StSandwich/ROV/Structure/Images/7b80ec35-c6fb-4c0f-8c48-df3105a3505e.png

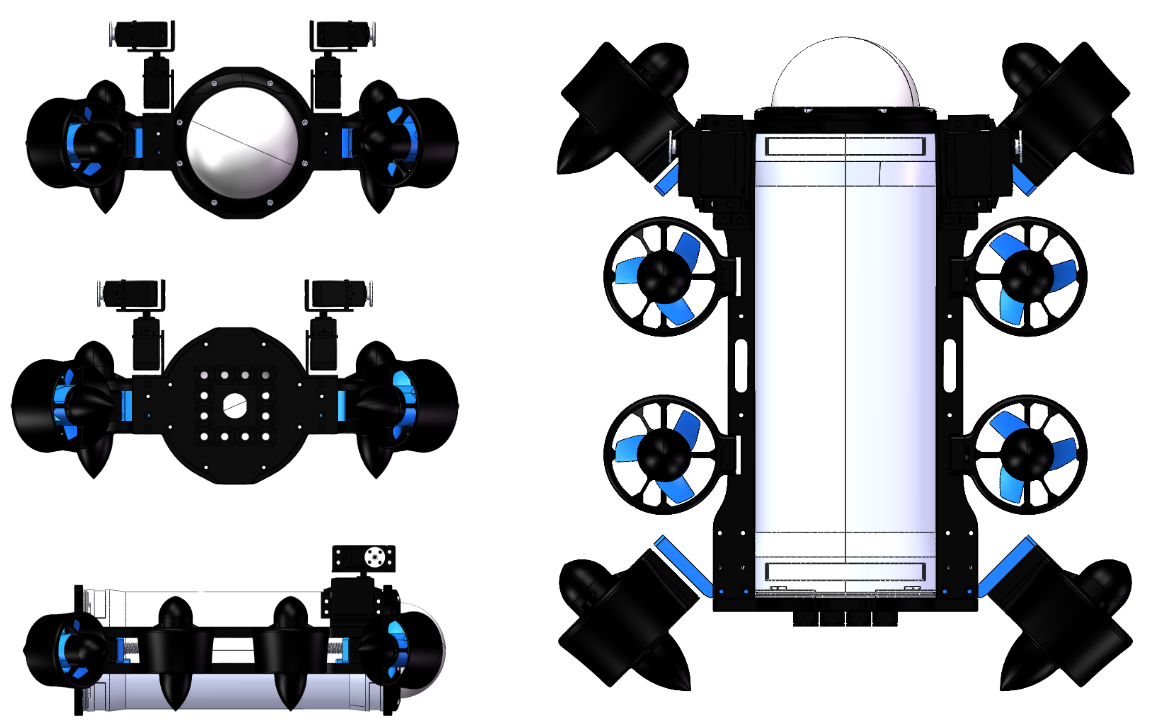
Structure/Images/7b80ec35-c6fb-4c0f-8c48-df3105a3505e.png
