StSandwich/ROV/Structure/En/BOM.xlsx

Type | Item Description | Link | Detail | Price(CNY) | Number | Note
Disclaimer | We are not affiliated with or endorse this company in any way. We have not tested or validated the product. Any such offerings are independent of our project.
 | If you are from regions outside mainland China or areas where Taobao e-commerce services are not readily available, you may refer to the BOM specifications to purchase equivalent items through convenient channels, but we cannot guarantee the consistency of the final assembly results. |  |  |  |  |  | The quantity of screws is for reference only; please prepare extra ones.
Essentials
Structure | Rear cabin hatch |  | Custom Aluminum Alloy CNC Machining | 240 | 1 |  | Category | Type | Number
 | Front cabin mount |  |  | 180 | 1 |  | Countersunk Head Hexagon Socket Screw | M3(Head Diameter6)*5 | 20
 | Thruster mount |  |  | 680 | 4 |  |  | M3(Head Diameter6)*10 | 8
 | Horizontal thruster bracket |  |  | 480 | 4 |  |  | M3(Head Diameter8)*8 | 16
 | Cable-passing screw |  |  | 1140 | 12 |  | Cup Head Hexagon Socket Screw | M4*16 | 32
 | Underwater aviation connector | https://item.taobao.com/item.htm?spm=a1z09.2.0.0.18002e8dzucueB&id=619481441943&_u=f2ig9se45843 | 3W 6-Core | 272 | 1 | Send cable directly to supplier for processing. |  | M3*16 | 20
 | Servo connector | https://item.taobao.com/item.htm?id=557166026079&sku_properties=31309:48651884 | Multifunctional Bracket | 18.4 | 4 |  |  | M3*12 | 45
 |  |  | Metal Servo Horn | 10 | 4 |  |  | M3*10 | 8
 | Waterproof compartment | https://item.taobao.com/item.htm?spm=a1z09.2.0.0.ef7d2e8dO2XjuV&id=662343463249&_u=92ig9se46f55 | Cabin Tube & Flange Kit + Hemispherical Cover + Pressure Plate | 515 | 1 |  |  | M2.5*8 | 4
 | Internal bracket of waterproof compartment | 3D打印 |  |  |  |  |  | M2*10 | 48
Electronics | Propeller | https://item.taobao.com/item.htm?spm=a1z09.2.0.0.ef7d2e8dO2XjuV&id=591864716045&_u=92ig9se435ad | 1 Pair of CW/CCW Propellers (Built-in ESC for 4S Voltage) | 2037 | 4 |  |  | M3*4 | 12
 | Servo | LIEYING/QFS2025全防水/潜水/水下机器人舵机全金属外壳IPX68等级-淘宝网 (taobao.com) (https://item.taobao.com/item.htm?_u=i20at7545jacc4&id=680656749408&spm=a1z09.2.0.0.3c6c2e8dmFwRSe) | 20KG (for Underwater Diving) Underwater Robot, 180° (0.5-2.5ms) | 432 | 4 | Custom extended cable, total length 1m. |  | M2.5*4 | 4
 | Water depth sensor | M10 水压水深传感器 高精度 深度传感器 MS5837-30BA 带温度 ROV-淘宝网 (taobao.com) (https://item.taobao.com/item.htm?_u=320at7545j5b4a&id=605375059849&spm=a1z09.2.0.0.2d472e8d3f5Wg1) | Standard Version, Stainless Steel, 10m, Sensor Adapter Board Kit | 1319.6 | 4 | Custom extended cable, total length 60cm. | Single-head Copper Spacer | M3*4+4 | 12
 | I2C expansion board | TCA9548A IIC多路扩展模块 8路I2C通信 I2C开关开发-淘宝网 (https://item.taobao.com/item.htm?id=677595693967&skuId=6126765579570) | Straight/Right-Angle Pin Headers | 10.56 | 1 |  |  | M2.5*4+4 | 4
 | PWM expansion board | 16路PWM Servo 舵机驱动板机器人控制器IIC接口驱动器模块PCA9685-tmall.com天猫 (https://detail.tmall.com/item.htm?_u=m20at7545j0770&id=624960039615&spm=a1z09.2.0.0.570d2e8dWadFaY) | Pre-Soldered | 15 | 1 |  | Hexagonal Single-head Nylon Spacer | M3*70+6 | 6
 | TTL to 422 converter | RS422互转TTL双向信号 全双工422转单片机MAX490转TTL模块-tmall.com天猫 (https://detail.tmall.com/item.htm?_u=q2ig9se4d19b&id=715839278393) |  | 9.1 | 1 |  |  | M3*45+6 | 3
 | 422 to USB converter | 绿联usb转rs485/422/232串口线工业级九针db9针数据调试接口通讯模块芯片连接笔记本和电脑口转接头转换器-tmall.com天猫 (https://detail.tmall.com/item.htm?id=599997955029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) | 1 Piece, Length Customizable | 79 | 1 |  |  | M3*40+6 | 3
 | Wireless debugger | 高速无线调试器DAPLink仿真器STM32编程烧录下载器塔克OpenCTR-淘宝网 (https://item.taobao.com/item.htm?abbucket=8&id=745548099223&ns=1&skuId=5310177214467&xxc=taobaoSearch) | 2 Debuggers + Dupont Cables | 89 | 2 |  | Cap Nut | M3 | 16
 | DJI RoboMaster C-board | ROBOMASTER萝马集市 开发板C型-淘宝网 (taobao.com) (https://item.taobao.com/item.htm?_u=i20at7545j5174&id=611226266955&spm=a1z09.2.0.0.292e2e8d43HZbM) |  | 379 | 1 |  | Hex Nut | M3 | 4
 | Camera |  | Either External Waterproof Camera or Internal Cabin Camera is Acceptable |  | 1 |  | Embedded Nut | M3*4+6 | 4
Others | Cable |  | Custom Zero-Buoyancy Cable: 2p*1mm² Power Cable + 4p Signal Cable
 | Screw |  | See the right table
 | Terminal block | https://item.taobao.com/item.htm?id=562191894078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 | h3802 10P | 25.2 | 2
 |  |  | Chocolate Color [EBL-10-5-Connector], Non-printed | 12.6 | 2
 |  | https://item.taobao.com/item.htm?spm=a1z09.2.0.0.5b912e8dQl5wtC&id=661948958655&_u=h2ig9se4f606 | h3800 12P | 36 | 2
 |  |  | h3800 16P | 24 | 1
 | Terminal block
 | Dupont adapter cable |  | 4P 100mm to Dupont Female SH1.25; 3P 100mm to Dupont Female GH1.25
 | Dupont cable |  | 6-Color Male to Female, 10cm
 | Waterproof gasket | 绿色氟胶O型圈外10.5/11/11.5/12/12.5/13/13.5/14/14.5/15*1.5mm-tmall.com天猫 (https://detail.tmall.com/item.htm?id=680012535670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) | Outer Diameter 12mm*1.5mm |  | 12
