StSandwich/ROV/Structure/En/CNC_Machining/CNC_Maching.xlsx

Name | Quantity | Material | Remarks
Front_Cabin_Mount | 1 | Al Alloy Anodized Black
Rear_Cabin_Hatch | 1 | Al Alloy Anodized Black | All similar locations here: drill & tap M2 threaded holes, depth 4 mm, Qty. 48
Thruster_Mount | 4 | Al Alloy Anodized Black | All similar locations here: drill & tap M3 threaded holes, depth 10 mm, Qty. 12
Horizontal_Thruster_Bracket | 4 | Al Alloy Anodized Blue | All similar locations here: drill & tap M3 threaded holes, depth 8 mm, Qty. 6
Cable-passing_Screw | 12 | Al Alloy Anodized Black
