StSandwich/ROV/Structure/zh-CN/bom表.xlsx

类别 | 材料名称 | 购买链接 | 型号 | 价格 | 数量 | 备注
声明 | 本表格不涉及任何广告，物料均为机器人标准件，我方与店家无任何关联，亦未对其进行背书。我方尚未对该产品开展测试或验证工作，相关产品服务均独立于本项目存在
 |  |  |  |  |  |  | 螺丝数量仅供参考，请多预备
核心配件清单
机械零件 | 后密封舱盖支撑 |  | 铝合金CNC定制 | 240 | 1 |  | 螺丝种类 | 型号 | 数量
 | 前密封舱支撑 |  |  | 180 | 1 |  | 扁头内六角螺丝 | M3(头径6)*5 | 20
 | 推进器支撑 |  |  | 680 | 4 |  |  | M3(头径6)*10 | 8
 | 水平推进器架 |  |  | 480 | 4 |  |  | M3(头径8)*8 | 16
 | 穿线螺丝 |  |  | 1140 | 12 |  | 杯头内六角螺丝 | M4*16 | 32
 | 水下航插 | https://item.taobao.com/item.htm?spm=a1z09.2.0.0.18002e8dzucueB&id=619481441943&_u=f2ig9se45843 | 3W 6芯 | 272 | 1 | 可以将电缆直接寄给商家加工 |  | M3*16 | 20
 | 舵机连接件 | https://item.taobao.com/item.htm?id=557166026079&sku_properties=31309:48651884 | 多功能支架 | 18.4 | 4 |  |  | M3*12 | 45
 |  |  | 金属舵盘 | 10 | 4 |  |  | M3*10 | 8
 | 防水舱 | https://item.taobao.com/item.htm?spm=a1z09.2.0.0.ef7d2e8dO2XjuV&id=662343463249&_u=92ig9se46f55 | 舱管和法兰套装+ 半球罩+压板 | 515 | 1 |  |  | M2.5*8 | 4
 | 防水舱内部支架 | 3D打印 |  |  |  |  |  | M2*10 | 48
电气设备 | 推进器 | https://item.taobao.com/item.htm?spm=a1z09.2.0.0.ef7d2e8dO2XjuV&id=591864716045&_u=92ig9se435ad | 正反桨（4S电压内置电调）一对（开票价） | 2037 | 4 |  |  | M3*4 | 12
 | 舵机 | LIEYING/QFS2025全防水/潜水/水下机器人舵机全金属外壳IPX68等级-淘宝网 (taobao.com) (https://item.taobao.com/item.htm?_u=i20at7545jacc4&id=680656749408&spm=a1z09.2.0.0.3c6c2e8dmFwRSe) | 20KG（水下潜水用）水下机器人 180度（0.5-2.5ms） | 432 | 4 | 需要定制加长线，总长1m |  | M2.5*4 | 4
 | 水深传感器 | M10 水压水深传感器 高精度 深度传感器 MS5837-30BA 带温度 ROV-淘宝网 (taobao.com) (https://item.taobao.com/item.htm?_u=320at7545j5b4a&id=605375059849&spm=a1z09.2.0.0.2d472e8d3f5Wg1) | 标准版 不锈钢 10m 传感器转接板套装 | 1319.6 | 4 | 需要定制加长线，总长60cm | 单头铜柱 | M3*4+4 | 12
 | IIC扩展板 | TCA9548A IIC多路扩展模块 8路I2C通信 I2C开关开发-淘宝网 (https://item.taobao.com/item.htm?id=677595693967&skuId=6126765579570) | 直/弯排针 | 10.56 | 1 |  |  | M2.5*4+4 | 4
 | PWM扩展板 | 16路PWM Servo 舵机驱动板机器人控制器IIC接口驱动器模块PCA9685-tmall.com天猫 (https://detail.tmall.com/item.htm?_u=m20at7545j0770&id=624960039615&spm=a1z09.2.0.0.570d2e8dWadFaY) | 焊好 | 15 | 1 |  | 六角单头尼龙柱 | M3*70+6 | 6
 | TTL转422 | RS422互转TTL双向信号 全双工422转单片机MAX490转TTL模块-tmall.com天猫 (https://detail.tmall.com/item.htm?_u=q2ig9se4d19b&id=715839278393) |  | 9.1 | 1 |  |  | M3*45+6 | 3
 | 422转USB | 绿联usb转rs485/422/232串口线工业级九针db9针数据调试接口通讯模块芯片连接笔记本和电脑口转接头转换器-tmall.com天猫 (https://detail.tmall.com/item.htm?id=599997955029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) | 1条，长度自选 | 79 | 1 |  |  | M3*40+6 | 3
 | 无线调试器 | 高速无线调试器DAPLink仿真器STM32编程烧录下载器塔克OpenCTR-淘宝网 (https://item.taobao.com/item.htm?abbucket=8&id=745548099223&ns=1&skuId=5310177214467&xxc=taobaoSearch) | 两个调试器+杜邦线 | 89 | 2 |  | 盖形螺母 | M3 | 16
 | 大疆RM C板 | ROBOMASTER萝马集市 开发板C型-淘宝网 (taobao.com) (https://item.taobao.com/item.htm?_u=i20at7545j5174&id=611226266955&spm=a1z09.2.0.0.292e2e8d43HZbM) |  | 379 | 1 |  | 六角螺母 | M3 | 4
 | 相机 |  | 外置防水相机或者舱内相机都可以 |  | 1 |  | 预埋螺母 | M3*4+6 | 4
其他 | 电缆 |  | 定制零浮力电缆 2p*1mm^2电源线+4p信号线 |  |  | 按需求定制长度 |  | M3*4+4 | 14
 | 螺丝 |  | 见右侧 |  |  |  |  | M2.5*3.5+4 | 4
 | 接线端子 | https://item.taobao.com/item.htm?id=562191894078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 | h3802 10p | 25.2 | 2
 |  |  | 巧克力色[EBL-10-5-连接件]不印字 | 12.6 | 2
 |  | https://item.taobao.com/item.htm?spm=a1z09.2.0.0.5b912e8dQl5wtC&id=661948958655&_u=h2ig9se4f606 | h3800 12p | 36 | 2
 |  |  | h3800 16p | 24 | 1
 | 接线端子
 | 杜邦转接线 |  | 4p100mm转杜邦母sh1.25 3p100mm转杜邦母gh1.25
 | 杜邦线 |  | 六色公对母10cm
 | 防水垫圈 | 绿色氟胶O型圈外10.5/11/11.5/12/12.5/13/13.5/14/14.5/15*1.5mm-tmall.com天猫 (https://detail.tmall.com/item.htm?id=680012535670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) | 外径12mm*1.5mm |  | 12
