StSandwich/ROV/Structure/zh-CN/CNC加工/CNC加工.xlsx

名称 | 数量 | 材料 | 备注
前密封舱支撑 | 1 | 铝合金，氧化黑
后密封舱盖 | 1 | 铝合金，氧化黑 | 此处所有类似地方需要做成m2螺纹孔，深4mm，共48个
推进器支撑 | 4 | 铝合金，氧化黑 | 此处需要做成m3螺纹孔，共12个
水平推进器架 | 4 | 铝合金，氧化蓝 | 此处需要做成m3螺纹孔，共6个
穿线螺丝M8 | 12 | 铝合金，氧化黑
