StSandwich/ROV/Structure/Configuration.STEP

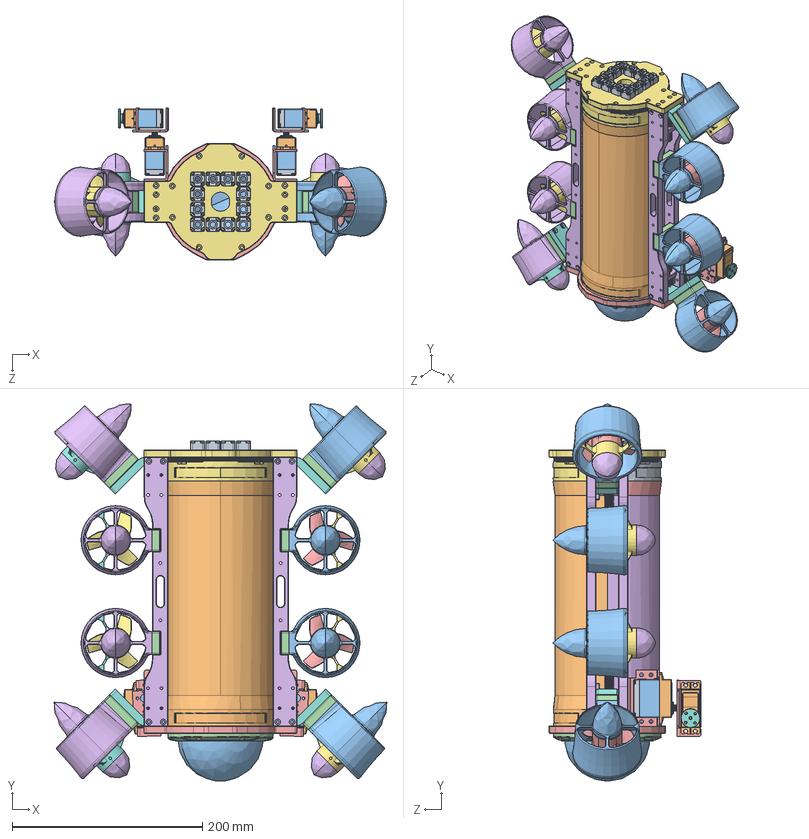
[picture p2: CAD file, 2026-01-31]
Structure/Configuration.STEP
349.5 x 396.2 x 159.6 mm
Cabin
YD11-24-2.stp x 4
PRT0001.stp x 4
9-16-2.stp x 4
YD11-24-1.stp x 4
YD11-24-3.stp x 4
Horizontal_Thruster_Bracket x 4
Servo x 3
Front_Cabin_Mount
MirrorYD11-24-2.stp x 4
MirrorPRT0001.stp x 4
Mirror9-16-2.stp x 4
MirrorYD11-24-1.stp x 4
MirrorYD11-24-3.stp x 4
Mirror_Servo
Hemispherical_Dome
Servo_mount x 4
Pressure_Sensor_Mount x 4
Pressure_Sensor x 4
Thruster_Mount x 4
Rear_Cabin_Hatch
Servo_Horn x 2
Cable-passing_Screw x 12
