StSandwich/ROV/Structure/En/3DPrinting/Pressure_Sensor_Mount.STEP

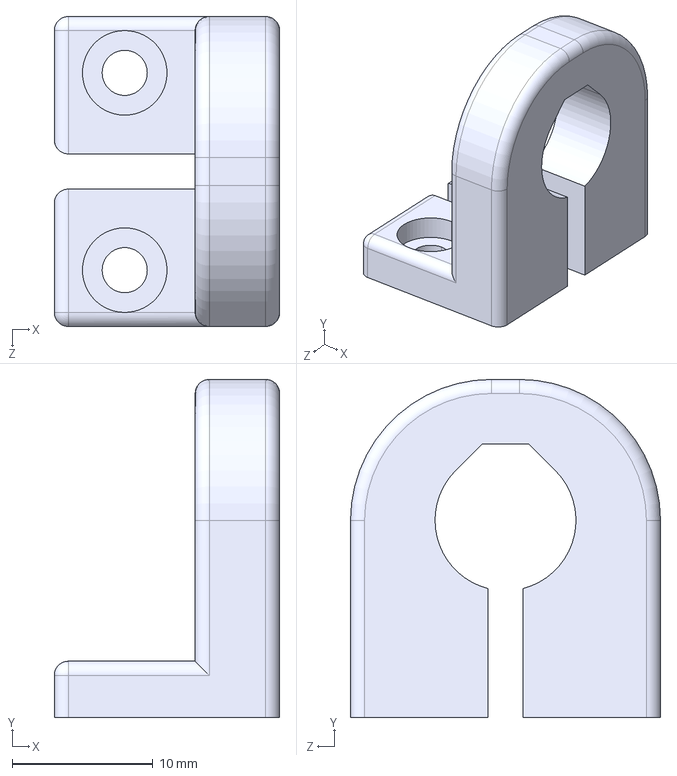
[picture p3: CAD file, 2026-01-31]
Structure/En/3DPrinting/Pressure_Sensor_Mount.STEP
16.0 x 24.0 x 22.0 mm
