StSandwich/ROV/Structure/En/Cabin/Cabin.STEP

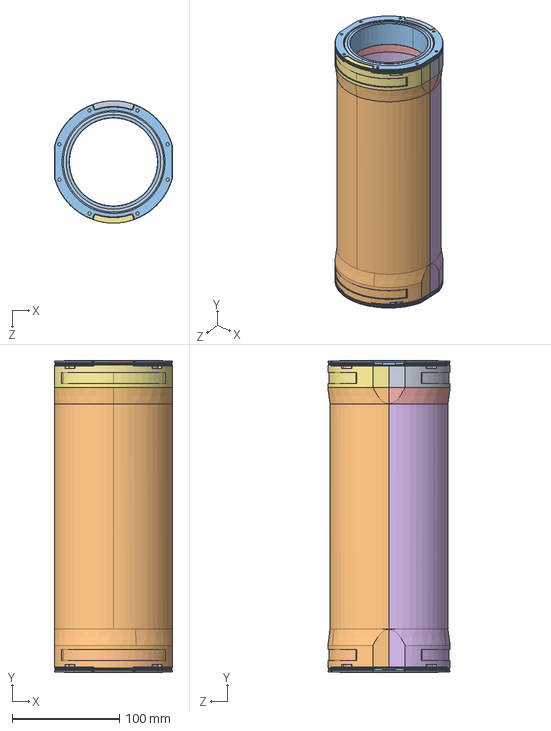
[picture p4: CAD file, 2026-01-31]
Structure/En/Cabin/Cabin.STEP
110.0 x 290.7 x 114.0 mm
