StSandwich/ROV/Structure/En/CNC_Machining/Rear_Cabin_Hatch.STEP

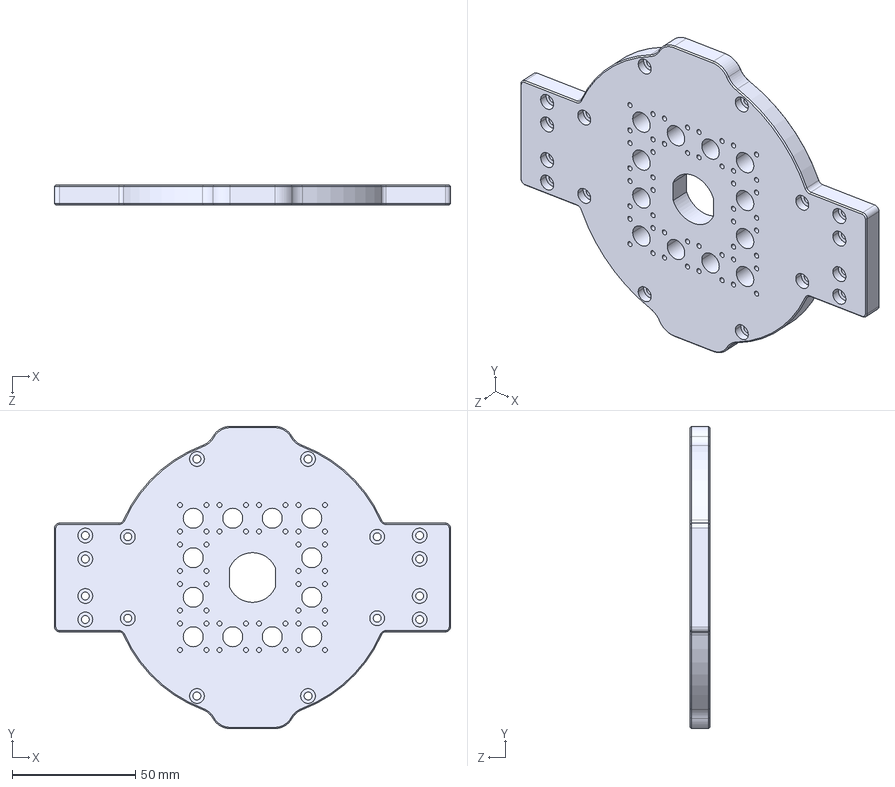
[picture p5: CAD file, 2026-01-31]
Structure/En/CNC_Machining/Rear_Cabin_Hatch.STEP
160.4 x 122.4 x 8.00 mm
