StSandwich/ROV/Structure/En/Configuration.STEP

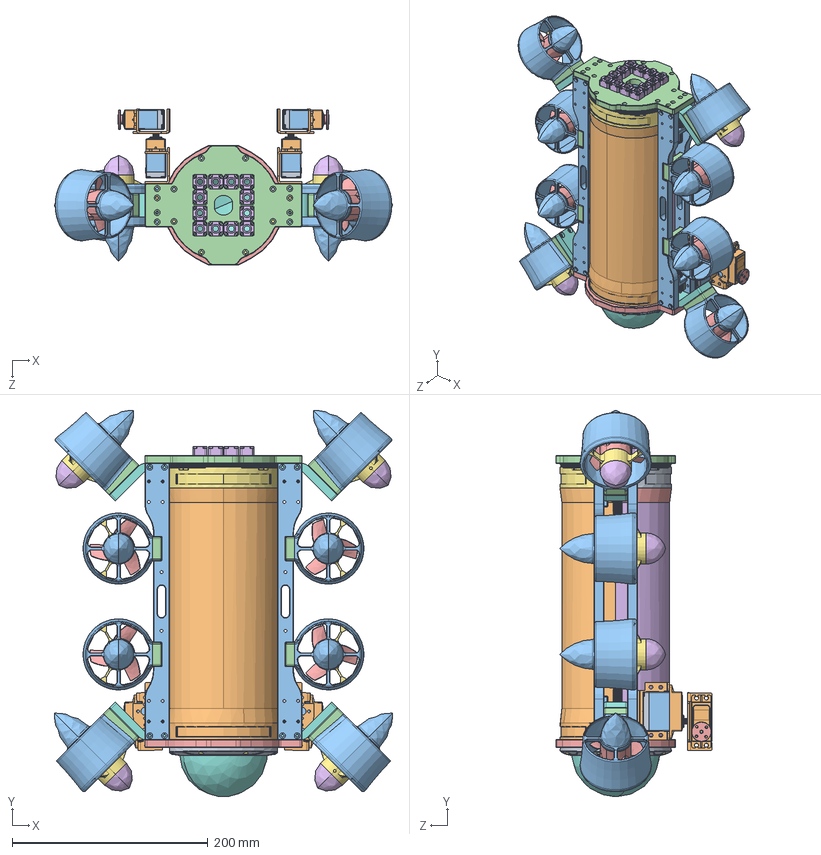
[picture p6: CAD file, 2026-01-31]
Structure/En/Configuration.STEP
345.0 x 393.9 x 159.6 mm
密封舱
YD11-24-2.stp x 8
PRT0001.stp x 8
9-16-2.stp x 8
YD11-24-1.stp x 8
YD11-24-3.stp x 8
水平推进器架 x 4
防水舵机 x 3
前密封舱支撑
镜向防水舵机
半球罩+压板
舵机多功能支架 x 4
水深传感器架 x 4
水深传感器 x 4
推进器支撑 x 4
后密封舱盖
舵盘 x 2
穿线螺丝M8 x 12
