StSandwich/ROV/Structure/En/Pressure_Sensor/Pressure_Sensor.STEP

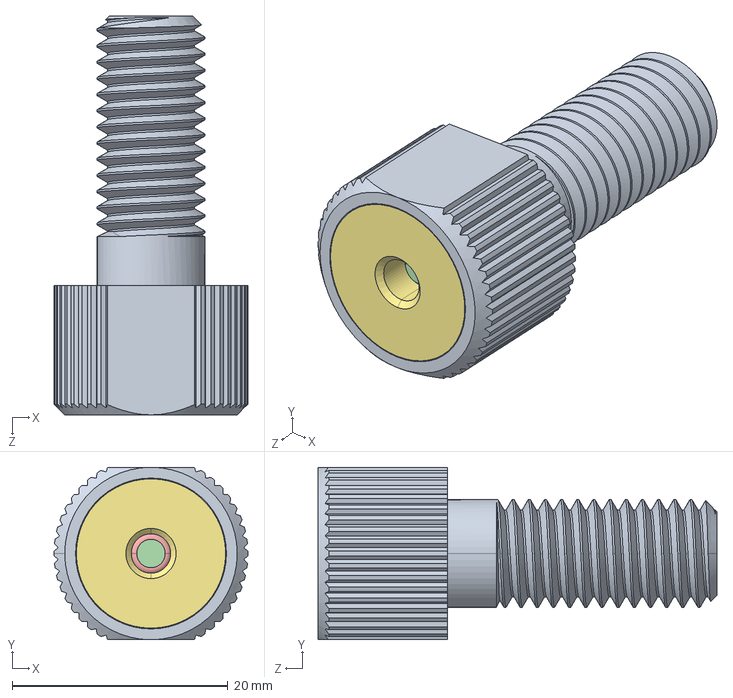
[picture p7: CAD file, 2026-01-31]
Structure/En/Pressure_Sensor/Pressure_Sensor.STEP
18.0 x 16.0 x 37.0 mm
