StSandwich/ROV/Structure/En/Servo/Servo_mount.STEP

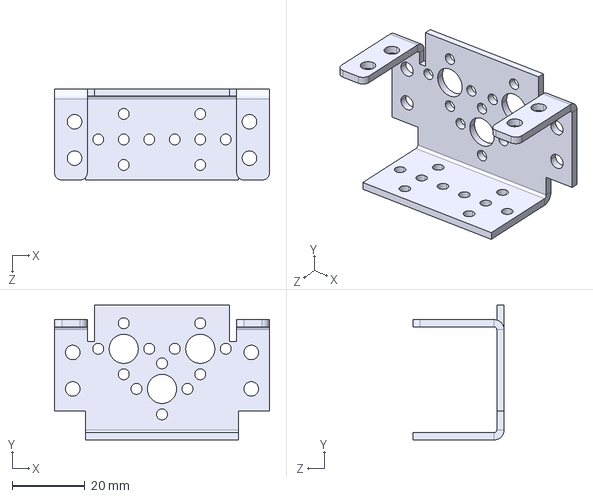
[picture p8: CAD file, 2026-01-31]
Structure/En/Servo/Servo_mount.STEP
59.0 x 37.0 x 25.0 mm
