StSandwich/ROV/Structure/En/Thruster/YD11-24-3.stp.STEP

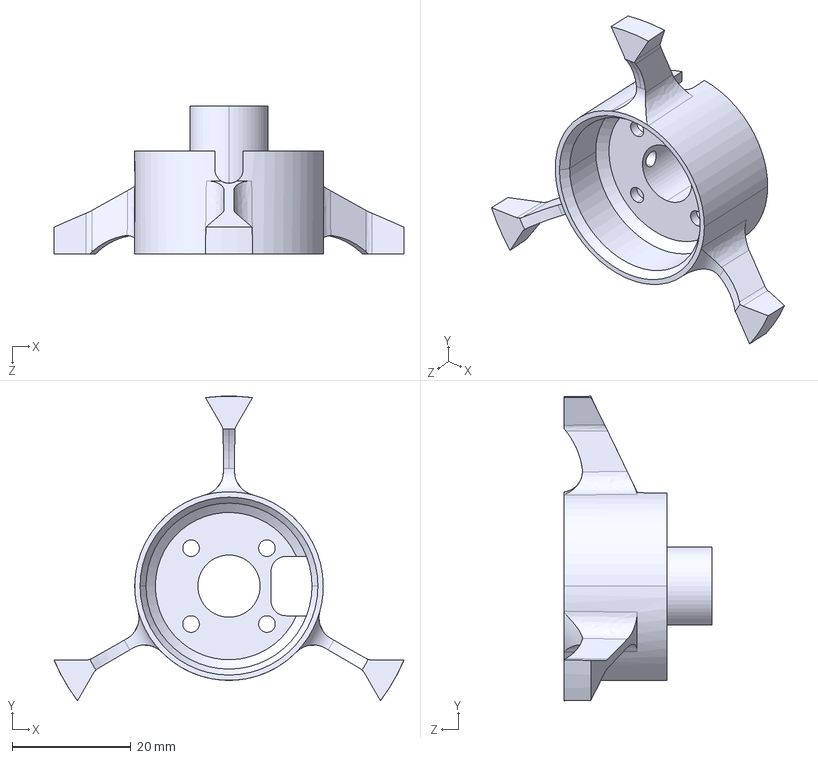
[picture p9: CAD file, 2026-01-31]
Structure/En/Thruster/YD11-24-3.stp.STEP
59.0 x 51.4 x 24.9 mm
