StSandwich/ROV/Structure/zh-CN/CNC加工/穿线螺丝M8.STEP

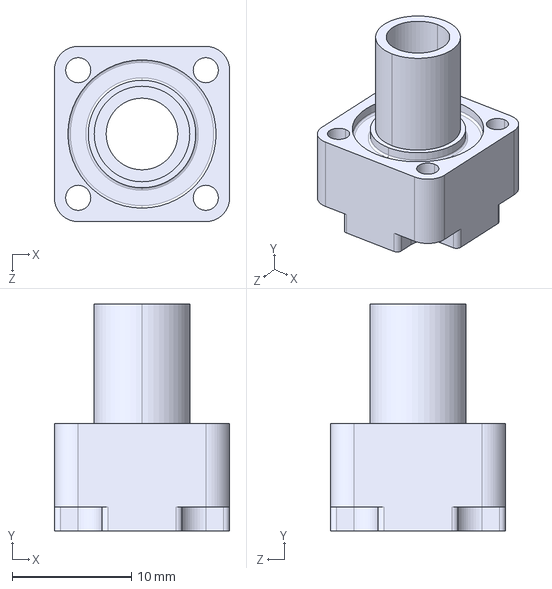
[picture p10: CAD file, 2026-01-31]
Structure/zh-CN/CNC加工/穿线螺丝M8.STEP
14.7 x 19.0 x 14.7 mm
