StSandwich/ROV/Structure/zh-CN/推进器/PRT0001.stp.STEP

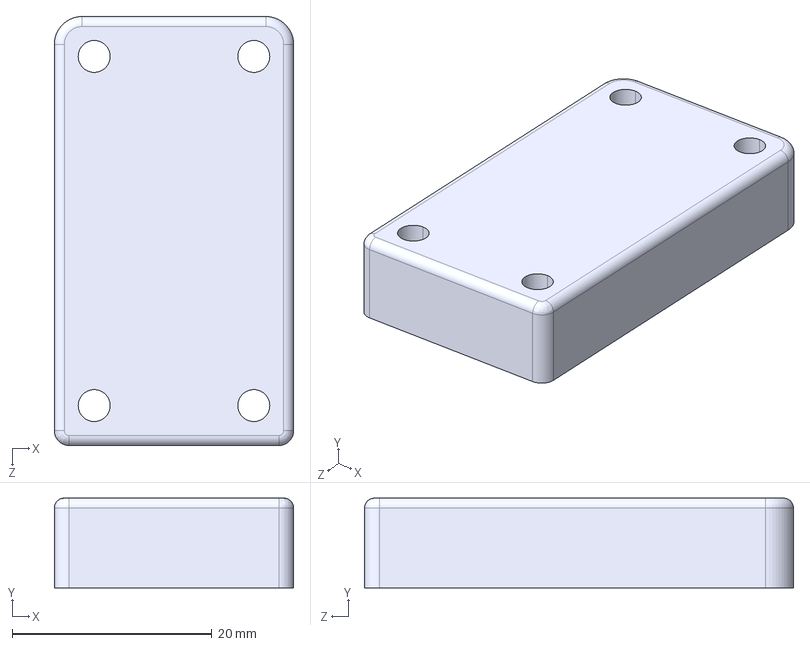
[picture p11: CAD file, 2026-01-31]
Structure/zh-CN/推进器/PRT0001.stp.STEP
24.0 x 9.00 x 43.0 mm
