StSandwich/ROV/Structure/En/Cabin/Hemispherical_Dome.STEP

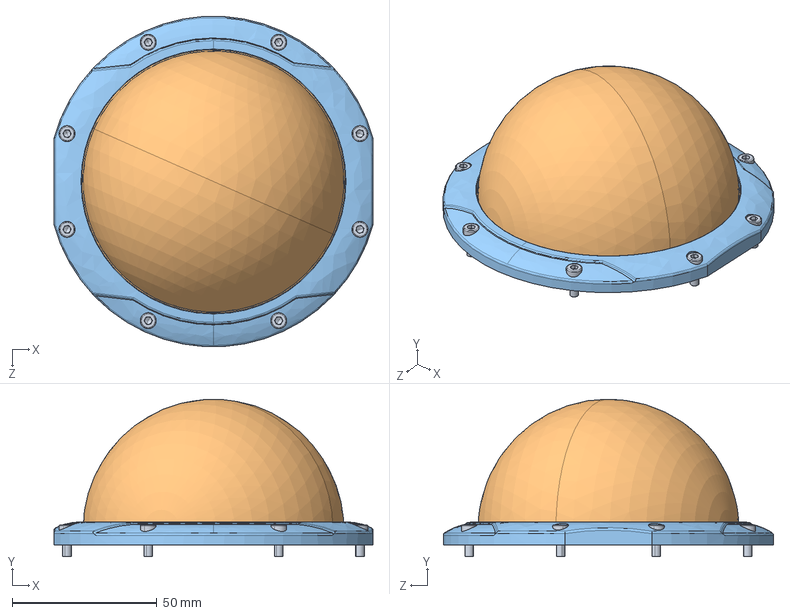
[picture p12: CAD file, 2026-01-31]
Structure/En/Cabin/Hemispherical_Dome.STEP
110.0 x 54.3 x 113.8 mm
