StSandwich/ROV/Structure/En/CNC_Machining/Front_Cabin_Mount.STEP

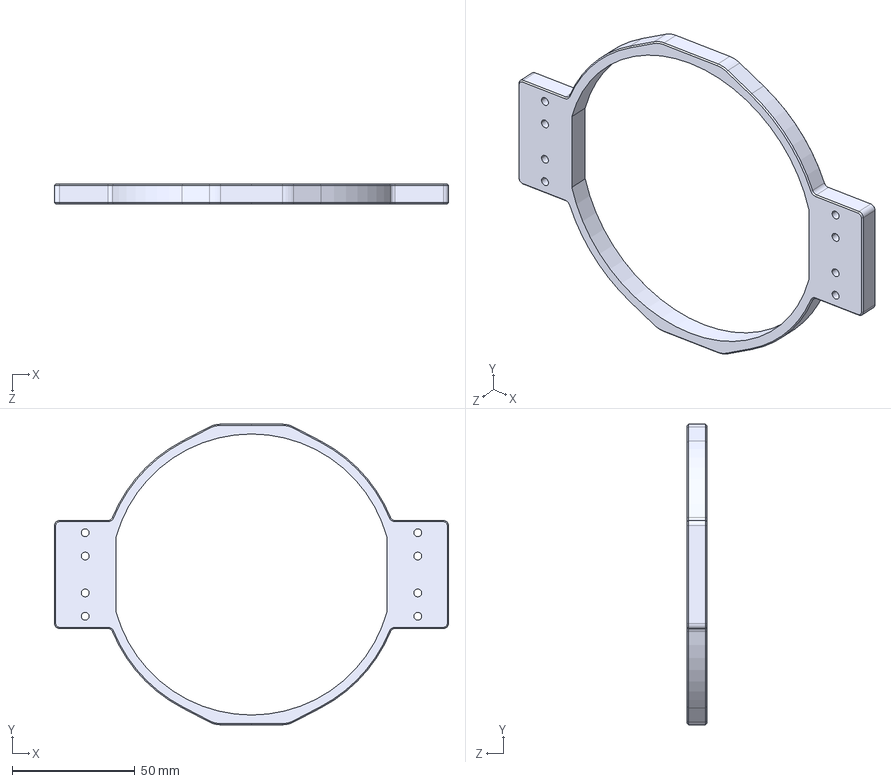
[picture p13: CAD file, 2026-01-31]
Structure/En/CNC_Machining/Front_Cabin_Mount.STEP
160.4 x 122.4 x 8.00 mm
