StSandwich/ROV/Structure/En/In-cabin_Layout.STEP

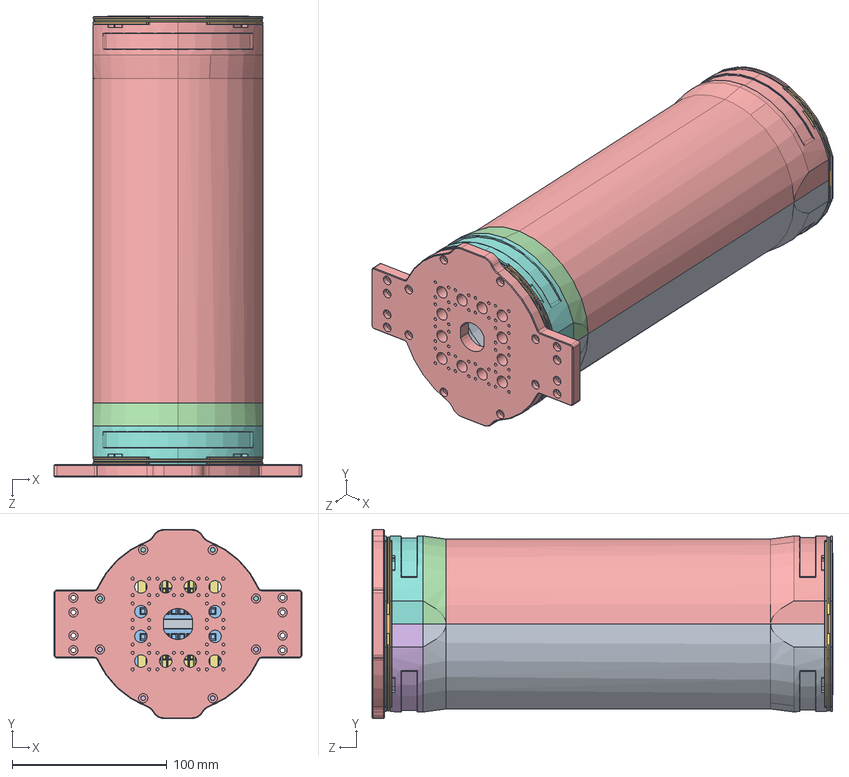
[picture p14: CAD file, 2026-01-31]
Structure/En/In-cabin_Layout.STEP
160.4 x 122.4 x 298.3 mm
接线端子支架
H3802-10P x 2
接线端子支架2 x 2
后密封舱盖
H3800-12P x 2
密封舱
电路板底板
H3800-16P
C板
I2C扩展板
PWM扩展板
stlink
电路板支架
