StSandwich/ROV/Structure/En/Servo/Servo.STEP

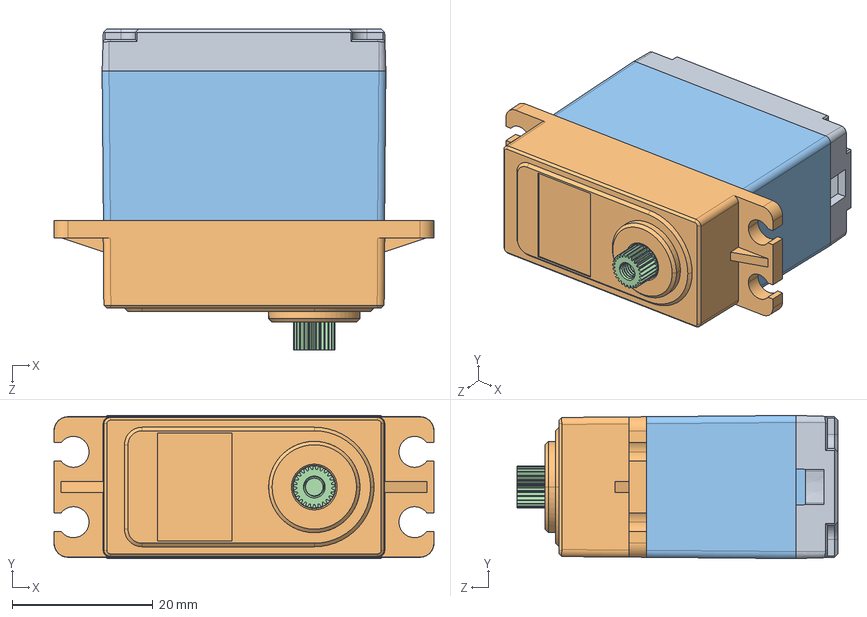
[picture p15: CAD file, 2026-01-31]
Structure/En/Servo/Servo.STEP
54.1 x 20.4 x 45.7 mm
