StSandwich/ROV/Structure/En/Thruster/YD11-24-1.stp.STEP

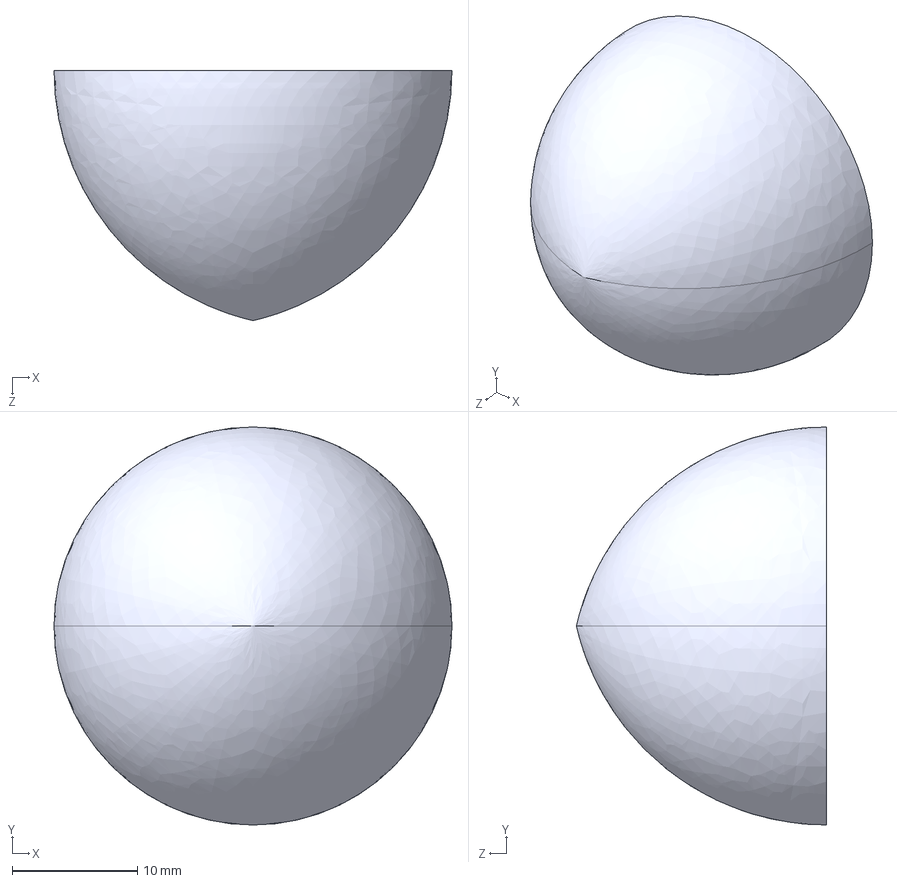
[picture p16: CAD file, 2026-01-31]
Structure/En/Thruster/YD11-24-1.stp.STEP
31.8 x 31.8 x 20.0 mm
