StSandwich/ROV/Structure/zh-CN/推进器/9-16-2.stp.STEP

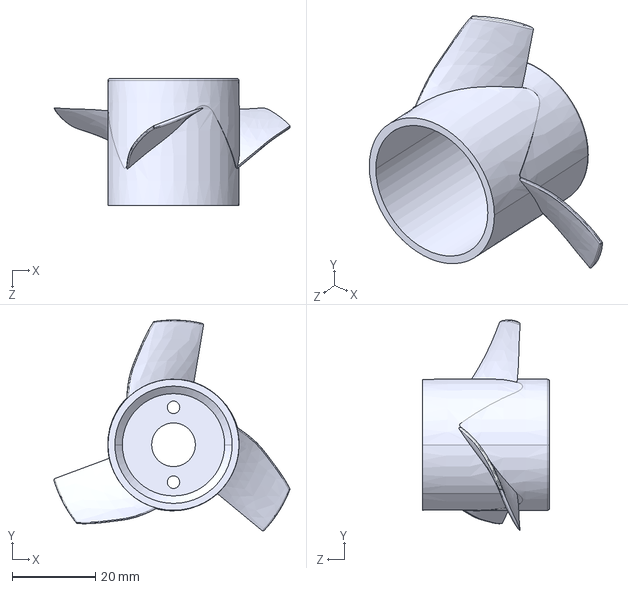
[picture p17: CAD file, 2026-01-31]
Structure/zh-CN/推进器/9-16-2.stp.STEP
56.8 x 50.7 x 30.6 mm
