StSandwich/ROV/Structure/En/CNC_Machining/Thruster_Mount.STEP

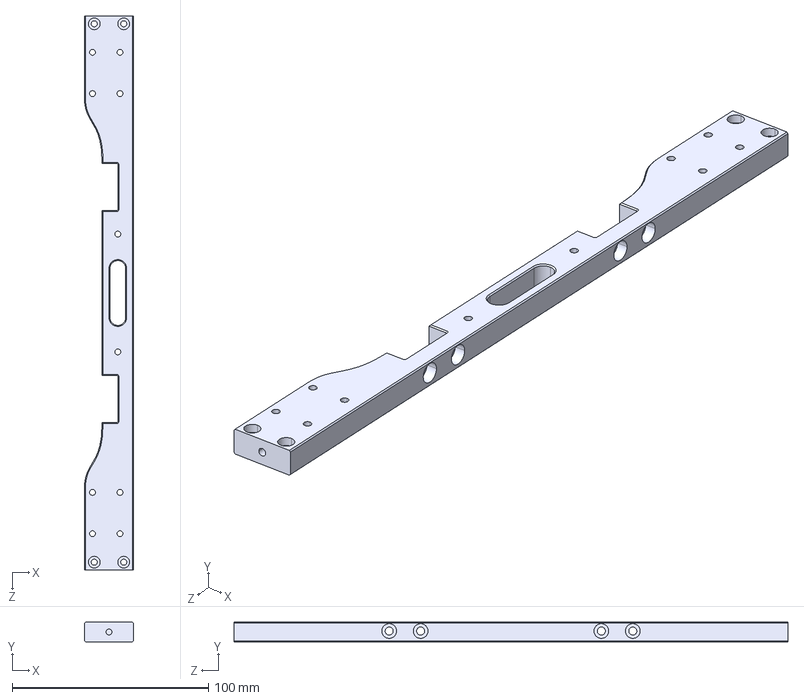
[picture p18: CAD file, 2026-01-31]
Structure/En/CNC_Machining/Thruster_Mount.STEP
25.0 x 10.0 x 282.0 mm
