StSandwich/ROV/Structure/En/Servo/Servo_Horn.STEP

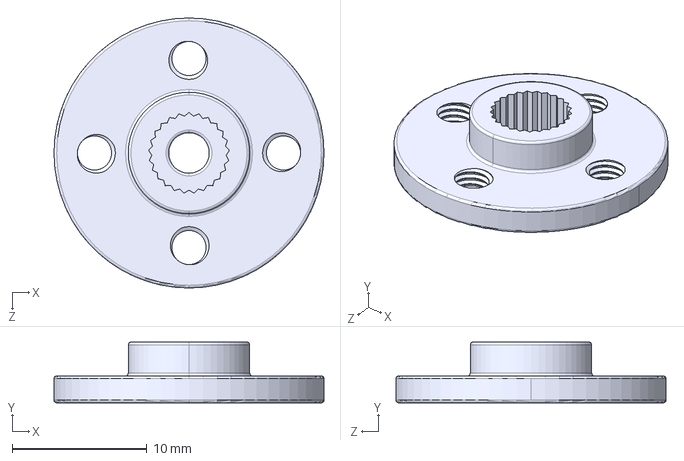
[picture p19: CAD file, 2026-01-31]
Structure/En/Servo/Servo_Horn.STEP
20.0 x 4.50 x 20.0 mm
