StSandwich/ROV/Structure/zh-CN/CNC加工/水平推进器架.STEP

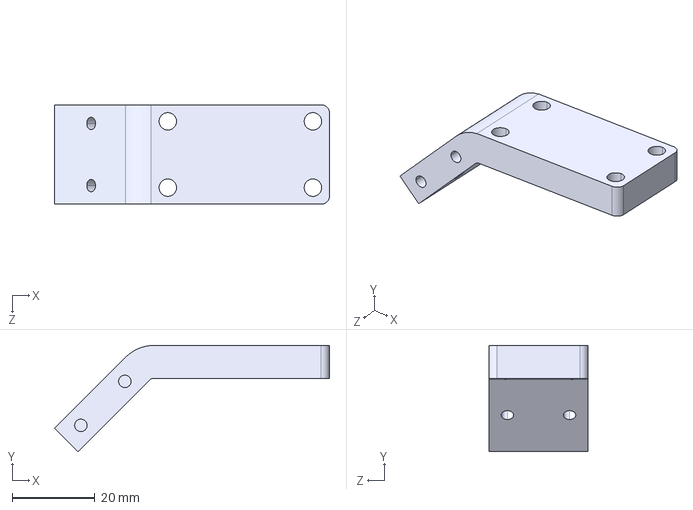
[picture p20: CAD file, 2026-01-31]
Structure/zh-CN/CNC加工/水平推进器架.STEP
66.3 x 25.7 x 24.0 mm
