StSandwich/ROV/Structure/zh-CN/推进器/YD11-24-2.stp.STEP

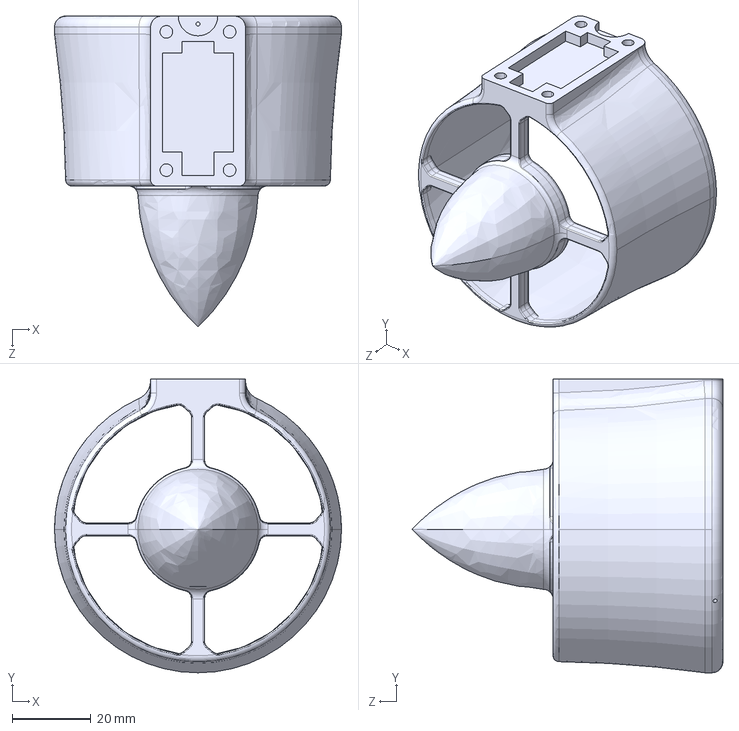
[picture p21: CAD file, 2026-01-31]
Structure/zh-CN/推进器/YD11-24-2.stp.STEP
72.7 x 74.3 x 78.7 mm
