StSandwich/ROV/(list of files, cad)

Other CAD files:
Structure/zh-CN/密封舱/密封舱.STEP
Structure/zh-CN/水深传感器/水深传感器架（3D打印）.STEP
Structure/zh-CN/舵机/舵机多功能支架.STEP
Structure/zh-CN/CNC加工/后密封舱盖.STEP
Structure/zh-CN/水深传感器/水深传感器.STEP
Structure/zh-CN/舵机/防水舵机.STEP
Structure/En/Thruster/Thruster.STEP
Structure/zh-CN/CNC加工/推进器支撑.STEP
Structure/zh-CN/推进器/YD11-24-1.stp.STEP
Structure/zh-CN/舵机/舵盘.STEP
Structure/En/Thruster/PRT0001.stp.STEP
Structure/En/CNC_Machining/Horizontal_Thruster_Bracket.STEP
Structure/En/Thruster/9-16-2.stp.STEP
Structure/zh-CN/CNC加工/前密封舱支撑.STEP
Structure/zh-CN/推进器/YD11-24-3.stp.STEP
Structure/En/Thruster/YD11-24-2.stp.STEP
Structure/zh-CN/推进器/推进器.STEP
Structure/En/CNC_Machining/Cable-passing_Screw.STEP
