StSandwich/ROV/Making_Instructions/接线.md

### I2C-Expand(TCA9548APWR)

0 -3 水深传感器

4 pwm扩展板

### PWM-Expand

0-7 推进器

8-10 舵机
