StSandwich/ROV/Code/LL_Modified/RM_Frame_C.ioc

Mcu.UserName=STM32F407IGHx
PA0-WKUP.GPIO_Label=KEY
PA0-WKUP.Signal=GPXTI0
PA11.Signal=USB_OTG_FS_DM
PA12.Signal=USB_OTG_FS_DP
PA13.Signal=SYS_JTMS-SWDIO
PA14.Signal=SYS_JTCK-SWCLK
PA4.GPIO_Label=CS1_ACCEL
PA4.Signal=GPIO_Output
PA7.Signal=SPI1_MOSI
PA8.Signal=I2C3_SCL
PA9.Signal=USART1_TX
PB0.GPIO_Label=CS1_GYRO
PB0.Signal=GPIO_Output
PB12.GPIO_Label=OLED_RST
PB12.Signal=GPIO_Output
PB13.Signal=SPI2_SCK
PB14.GPIO_Label=OLED_DC
PB14.Signal=GPIO_Output
PB15.Signal=SPI2_MOSI
PB3.Signal=SPI1_SCK
PB4.Signal=SPI1_MISO
PB5.Signal=CAN2_RX
PB6.Signal=CAN2_TX
PB7.Signal=USART1_RX
PC10.Signal=USART3_TX
PC11.Signal=USART3_RX
PC4.GPIO_Label=INT1_ACCEL
PC4.Signal=GPXTI4
PC5.GPIO_Label=INT1_GRYO
PC5.Signal=GPXTI5
PC6.Signal=S_TIM8_CH1
PC9.Signal=I2C3_SDA
PD0.Signal=CAN1_RX
PD1.Signal=CAN1_TX
PD14.Signal=S_TIM4_CH3
PE11.Signal=S_TIM1_CH2
PE13.Signal=S_TIM1_CH3
PE14.Signal=S_TIM1_CH4
PE9.Signal=S_TIM1_CH1
PF0.Signal=I2C2_SDA
PF1.Signal=I2C2_SCL
PF10.Signal=ADC3_IN8
PF6.Signal=S_TIM10_CH1
PG14.Signal=USART6_TX
PG3.GPIO_Label=IST8310_DRDY
PG3.Signal=GPXTI3
PG6.GPIO_Label=IST8310_RSTN
PG6.Signal=GPIO_Output
PG9.Signal=USART6_RX
PH0-OSC_IN.Signal=RCC_OSC_IN
PH1-OSC_OUT.Signal=RCC_OSC_OUT
PH10.GPIO_Label=LED_B
PH10.Signal=S_TIM5_CH1
PH11.GPIO_Label=LED_G
PH11.Signal=S_TIM5_CH2
PH12.GPIO_Label=LED_R
PH12.Signal=S_TIM5_CH3
PI2.Signal=SPI2_MISO
PI6.Signal=S_TIM8_CH2
PI7.Signal=S_TIM8_CH3
