StSandwich/ROV/Code/LL_Modified/Src/main.c

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
/* Includes ------------------------------------------------------------------*/
#include "main.h"
#include "adc.h"
#include "can.h"
#include "dma.h"
#include "i2c.h"
#include "iwdg.h"
#include "spi.h"
#include "tim.h"
#include "usart.h"
#include "usb_device.h"
#include "gpio.h"

/* USER CODE BEGIN Includes */
#include <stdarg.h>
#include <string.h>
#include <math.h>
#include <stdio.h>
#include "usbd_cdc_if.h"
/* USER CODE END Includes */

/* USER CODE BEGIN PTD */
#if defined(__ARMCC_VERSION)  /* Keil/ARMCC only - patched */

/*******************************************************************************
* Copyright (c) 2025.
 * IWIN-FINS Lab, Shanghai Jiao Tong University, Shanghai, China.
 * All rights reserved.
 ******************************************************************************/

#if __ARMCC_VERSION >= 6000000
__asm(".global __use_no_semihosting");
#elif __ARMCC_VERSION >= 5000000
#pragma import(__use_no_semihosting)
#else
#error Unsupported compiler
#endif

#include <rt_sys.h>
#include <rt_misc.h>
#include <time.h>

const char __stdin_name[] =  ":tt";
const char __stdout_name[] =  ":tt";
const char __stderr_name[] =  ":tt";

FILEHANDLE _sys_open(const char *name, int openmode){
    return 1;
}

int _sys_close(FILEHANDLE fh){
    return 0;
}

char *_sys_command_string(char *cmd, int len){
    return NULL;
}

int _sys_write(FILEHANDLE fh, const unsigned char *buf, unsigned len, int mode){
    return 0;
}

int _sys_read(FILEHANDLE fh, unsigned char *buf, unsigned len, int mode){
    return -1;
}

void _ttywrch(int ch){
}

int _sys_istty(FILEHANDLE fh){
    return 0;
}

int _sys_seek(FILEHANDLE fh, long pos){
    return -1;
}

long _sys_flen(FILEHANDLE fh){
    return -1;
}

void _sys_exit(int return_code) {
    while (1)
        ;
}

clock_t clock(void){
    clock_t tmp;
    return tmp;
}

void _clock_init(void){
}

time_t time(time_t *timer){
    time_t tmp;
    return tmp;
}

int system(const char *string){
    return 0;
}

#else
/* GCC: retargeting is provided by Src/syscalls.c + Src/sysmem.c */
#endif /* __ARMCC_VERSION */
/* USER CODE END PTD */


void SystemClock_Config(void);
/**
  * @brief  The application entry point.
  * @retval int
  */
#if 0  /* patched: real main() is userCode/devices/Src/Usermain.cpp */
int main(void)
{
  /* MCU Configuration--------------------------------------------------------*/

  /* Reset of all peripherals, Initializes the Flash interface and the Systick. */
  HAL_Init();

  /* Configure the system clock */
  SystemClock_Config();

  /* Initialize all configured peripherals */
  MX_GPIO_Init();
  MX_DMA_Init();
  MX_TIM5_Init();
  MX_TIM1_Init();
  MX_TIM4_Init();
  MX_TIM10_Init();
  MX_TIM8_Init();
  MX_ADC1_Init();
  MX_ADC3_Init();
  MX_USART1_UART_Init();
  MX_USART6_UART_Init();
  MX_USART3_UART_Init();
  MX_CAN1_Init();
  MX_CAN2_Init();
  MX_I2C3_Init();
  MX_SPI1_Init();
  MX_IWDG_Init();
  MX_USB_DEVICE_Init();
  MX_TIM6_Init();
  MX_TIM7_Init();
  MX_SPI2_Init();
  MX_I2C2_Init();
  /* Infinite loop */
  /* USER CODE BEGIN WHILE */
  while (1)
  {
    /* USER CODE END WHILE */

    /* USER CODE BEGIN 3 */
  }
  /* USER CODE END 3 */
}
#endif


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
