StSandwich/ROV/Code/LL_Modified/userCode/devices/Src/Sensor.cpp

#include "Sensor.h"
#include "Kalman_Filter.h"

extern I2C_HandleTypeDef hi2c2;

PressureSensor PressureSensor::pressure_sensor;

KalmanFilter Pressure_Kf[4] = {KalmanFilter(0.01, 0.05, 1.0, 0.0),
                               KalmanFilter(0.01, 0.05, 1.0, 0.0),
                               KalmanFilter(0.01, 0.05, 1.0, 0.0),
                               KalmanFilter(0.01, 0.05, 1.0, 0.0)};

/* ---------------------------------------------------------------------------
 * I2C helpers with retries.
 * The gauges share I2C2 with the PWM expander and this bus glitches often
 * enough that a single-shot transfer fails a large fraction of the time (a
 * measured conversion[] showed two channels never getting a reading at all).
 * Three attempts with a bus recovery in between fixes that in practice.
 * 带重试的 I2C 收发：本车这条 I2C 经常出错，单次尝试有很大比例失败
 * （实测有两个通道一次都没读成功过）。重试 3 次，中间做一次总线恢复。
 * --------------------------------------------------------------------------- */
#define PS_I2C_RETRIES 3

static HAL_StatusTypeDef ps_tx(uint16_t dev, uint8_t *buf, uint16_t n)
{
    HAL_StatusTypeDef st = HAL_ERROR;
    for (uint8_t k = 0; k < PS_I2C_RETRIES; ++k)
    {
        st = HAL_I2C_Master_Transmit(&hi2c2, dev, buf, n, MS5837_I2C_TIMEOUT);
        if (st == HAL_OK)
        {
            return st;
        }
        I2C2_Recover();
    }
    return st;
}

static HAL_StatusTypeDef ps_rx(uint16_t dev, uint8_t *buf, uint16_t n)
{
    HAL_StatusTypeDef st = HAL_ERROR;
    for (uint8_t k = 0; k < PS_I2C_RETRIES; ++k)
    {
        st = HAL_I2C_Master_Receive(&hi2c2, dev, buf, n, MS5837_I2C_TIMEOUT);
        if (st == HAL_OK)
        {
            return st;
        }
        I2C2_Recover();
    }
    return st;
}

void PressureSensor::Init()
{

		// ------ TODO: 3D coordinates of the four pressure sensors. These values must be obtained via measurement and updated accordingly.
    //------TODO:4个水压计三维坐标，由测量得到，需要修改
    Sensor_Site_t _site = {
        .x = {-12, 12, 12, -12},
        .y = {-5.4, -5.4, 5.4, 5.4},
        .z = {0, 0, 0, 0}
        /*.x={0},
        .y={1},
        .z={2},*/
    };
    site = _site;

    CurrentID = 0;

    // flag_Busy = 0;

    bsp_flash_read(&flashData);

    for (int i = 0; i < SENSOR_NUM; ++i)
    {
        TCA_SetChannel(i);
        HAL_Delay(5);
        Init_single(i);
    }

    data_plane[0] = 0;
    data_plane[1] = 0;
    data_plane[2] = 1;
    data_plane[3] = 0;
    data_plane[4] = 0;

    flag_calibrate = false;
    flag_read_pres = false;

    /*quat[0]=1.0f;
    quat[1]=0.0f;
    quat[2]=0.0f;
    quat[3]=0.0f;
*/
}

void PressureSensor::Handle()
{
    // if(tim_id == 1){
    // flag_Busy = 1;

    /* The gauges share the bus with the PWM expander; if a transfer glitched we
     * have to un-wedge the peripheral or every later read silently fails.
     * 水压计和 PWM 扩展板共用 I2C，总线卡住后必须先恢复，否则之后每次读都失败。 */
    I2C2_RecoverIfWedged();

    if (flag_calibrate)
    {
        Calibrate(); // Calibration 校准
        flag_calibrate = false;
    }
    else
    {
        Handle_all();
    }
    /*
    Update_plane();//计算机器人参考系下水面方程
    data_depth=-data_plane[3];//计算深度
    pitch=atan(-data_plane[0]/(sqrt(data_plane[1]*data_plane[1]+data_plane[2]*data_plane[2])));//计算俯仰角
    roll=atan(data_plane[1]/data_plane[2]);//计算横滚角
     */
    data_depth = (data_pressure[3] + data_pressure[2] + data_pressure[1] + data_pressure[0]) / 4;
    data_roll = data_pressure[0] + data_pressure[1] - data_pressure[2] - data_pressure[3];
    data_pitch = data_pressure[0] + data_pressure[3] - data_pressure[1] - data_pressure[2];
}

void PressureSensor::Receive()
{
    if (strncmp((char *)RxBuffer, "CA", 2) == 0)
    {
        flag_calibrate = true;
    }
    else if (strncmp((char *)RxBuffer, "VA", 2) == 0)
    {
        flag_read_pres = true;
    }
}

void PressureSensor::Delay_us(uint32_t us)
{
    uint32_t i;
    for (i = 0; i < us; i++)
    {
        int a = 10; // delay based on main clock, 168Mhz
        while (a--);
    }
}

unsigned char PressureSensor::MS5837_30BA_Crc4(int id)
{
    int cnt;
    int t;
    unsigned int n_rem = 0;
    unsigned char n_bit;
    unsigned char a = 0;
    unsigned char b = 0;
    unsigned short int n_prom[8];

    for (t = 0; t < 7; t++)
    {
        n_prom[t] = Cal_C[id][t];
    }
    n_prom[0] = ((n_prom[0]) & 0x0FFF);
    n_prom[7] = 0;
    for (cnt = 0; cnt < 16; cnt++)
    {
        if (cnt % 2 == 1)
            n_rem ^= (unsigned short)((n_prom[cnt >> 1]) & 0x00FF);
        else
            n_rem ^= (unsigned short)(n_prom[cnt >> 1] >> 8);
        for (n_bit = 8; n_bit > 0; n_bit--)
        {
            if (n_rem & (0x8000))
                n_rem = (n_rem << 1) ^ 0x3000;
            else
                n_rem = (n_rem << 1);
        }
    }
    n_rem = ((n_rem >> 12) & 0x000F);
    a = (n_rem ^ 0x00);
    b = Cal_C[id][0] >> 12;
    if (a == b)
    {
        return 1;
    }
    else
        return 0;
}

void PressureSensor::MS5837_30BA_ReSet(void)
{
    uint8_t data[1];
    data[0] = MS5837_30BA_ResetCommand;
    ps_tx(B02_IIC_ADDRESS, data, 1);
}

uint8_t PressureSensor::MS5837_30BA_PROM(int id)
{
    uint8_t memaddr[1];
    uint8_t data[2];
    int i;

    MS5837_30BA_ReSet();
    HAL_Delay(20);
    for (i = 0; i < 7; i++)
    {
        memaddr[0] = MS5837_30BA_PROM_RD + (i * 2);
        ps_tx(B02_IIC_ADDRESS, memaddr, 1);
        ps_rx(B02_IIC_ADDRESS, data, 2);
        Cal_C[id][i] = (((uint16_t)data[0] << 8) | data[1]);
    }
    return !Cal_C[id][0];
}

unsigned long PressureSensor::MS5837_30BA_GetConversion(uint8_t command)
{
    unsigned long conversion = 0;
    uint8_t data = MS5837_30BA_ADC_RD;
    uint8_t temp[3];
    ps_tx(B02_IIC_ADDRESS, &command, 1);
    HAL_Delay(2);
    // Delay_us(15000);
    ps_tx(B02_IIC_ADDRESS, &data, 1);

    ps_rx(B02_IIC_ADDRESS, temp, 3);
    conversion = (unsigned long)temp[0] * 65536 + (unsigned long)temp[1] * 256 + (unsigned long)temp[2];
    return conversion;
}

/*signed int PressureSensor::MS5837_30BA_GetTemp(int id)
{
    if(flag_ok[id]) {
        D2_Temp = MS5837_30BA_GetConversion(MS5837_30BA_D2_OSR_8192);
        HAL_Delay(20);
        dT = D2_Temp - (((uint32_t) Cal_C[id][5]) * 256l);
        return dT;
    }
    else return -1;
}*/

float PressureSensor::MS5837_30BA_GetData(int id)
{

    if (flag_ok[id])
    {
        D2_Temp = MS5837_30BA_GetConversion(MS5837_30BA_D2_OSR1024);
        // HAL_Delay(1);
        // Delay_us(30000);
        D1_Pres = MS5837_30BA_GetConversion(MS5837_30BA_D1_OSR1024);
        // HAL_Delay(3);
        // Delay_us(30000);
        dT = D2_Temp - (((uint32_t)Cal_C[id][5]) * 256l);
        SENS = (int64_t)Cal_C[id][1] * 65536l + ((int64_t)Cal_C[id][3] * dT) / 128l;
        OFF_ = (int64_t)Cal_C[id][2] * 131072l + ((int64_t)Cal_C[id][4] * dT) / 64l;

        TEMP = 2000l + (int64_t)(dT)*Cal_C[id][6] / 8388608LL;


        if (TEMP < 2000) // low temp
        {

            Ti = (11 * (int64_t)(dT) * (int64_t)(dT) / (34359738368LL));
            OFFi = (31 * (TEMP - 2000) * (TEMP - 2000)) / 8;
            SENSi = (63 * (TEMP - 2000) * (TEMP - 2000)) / 32;
        }
        else
        { // high temp
            Ti = 2 * (dT * dT) / (137438953472LL);
            OFFi = (1 * (TEMP - 2000) * (TEMP - 2000)) / 16;
            SENSi = 0;
        }
        OFF2 = OFF_ - OFFi;
        SENS2 = SENS - SENSi;
        /*if(D1_Pres==0||D2_Temp==0) return last_measure[id];
        else{
            float pressure = ((D1_Pres * SENS2) / 2097152.0 - OFF2) / 32768.0 / 100.0;
            last_measure[id]=pressure;
            return pressure;

        }*/
        float pressure = ((D1_Pres * SENS2) / 2097152.0 - OFF2) / 32768.0 / 100.0;
        return pressure;




    }
    else
        return -1;
}

void PressureSensor::Init_single(int id)
{
    data_pressure_offset[id] = 0;
    if (!flag_ok[id])
    {
        MS5837_30BA_PROM(id);
        flag_ok[id] = MS5837_30BA_Crc4(id);
    }
		// ------ TODO: Update the bias values here after receiving the calibration data.
    //------TODO:收到校准数据后修改此处零偏值
    /*
        for(int i=0;i<4;++i){
            data_pressure_offset[i] = flashData.pressure_offset[i]/1000.0;
        }
        */
    switch (Robot_Version)
    {
    case V30:
        data_pressure_offset[0] = PRESSURE_0_V30;
        data_pressure_offset[1] = PRESSURE_1_V30;
        data_pressure_offset[2] = PRESSURE_2_V30;
        data_pressure_offset[3] = PRESSURE_3_V30;
        break;
    case V31:
        data_pressure_offset[0] = PRESSURE_0_V31;
        data_pressure_offset[1] = PRESSURE_1_V31;
        data_pressure_offset[2] = PRESSURE_2_V31;
        data_pressure_offset[3] = PRESSURE_3_V31;
        break;
    case V32:
        data_pressure_offset[0] = PRESSURE_0_V32;
        data_pressure_offset[1] = PRESSURE_1_V32;
        data_pressure_offset[2] = PRESSURE_2_V32;
        data_pressure_offset[3] = PRESSURE_3_V32;
		break;
    case V33:
        data_pressure_offset[0] = PRESSURE_0_V33;
        data_pressure_offset[1] = PRESSURE_1_V33;
        data_pressure_offset[2] = PRESSURE_2_V33;
        data_pressure_offset[3] = PRESSURE_3_V33;
		break;
    case V40:
        data_pressure_offset[0] = PRESSURE_0_V40;
        data_pressure_offset[1] = PRESSURE_1_V40;
        data_pressure_offset[2] = PRESSURE_2_V40;
        data_pressure_offset[3] = PRESSURE_3_V40;
		break;
    }
}

void PressureSensor::Calibrate()
{
    for (int i = 0; i < SENSOR_NUM; ++i)
    {
        TCA_SetChannel(i);
        // HAL_Delay(5);
        Calibrate_single(i);
    }
    // bsp_flash_write(&flashData);
}

void PressureSensor::Calibrate_single(int id)
{
    uint8_t TxBuffer[SENSOR_NUM * 9] = {0};
    data_pressure_offset[id] = 0;
    for (int j = 0; j < 100; ++j)
    {
        data_pressure_raw[id] = MS5837_30BA_GetData(id);
        data_pressure_offset[id] += data_pressure_raw[id] / 100;
    }
    int data_temp = (int)(data_pressure_offset[id] * 1000);
    // flashData.pressure_offset[id] = data_temp;
    int data_digit[7];
    for (int j = 0; j < 7; ++j)
    {
        data_digit[j] = data_temp % 10;
        data_temp /= 10;
    }
    TxBuffer[id * 9] = '0' + data_digit[6];
    TxBuffer[id * 9 + 1] = '0' + data_digit[5];
    TxBuffer[id * 9 + 2] = '0' + data_digit[4];
    TxBuffer[id * 9 + 3] = '0' + data_digit[3];
    TxBuffer[id * 9 + 4] = '.';
    TxBuffer[id * 9 + 5] = '0' + data_digit[2];
    TxBuffer[id * 9 + 6] = '0' + data_digit[1];
    TxBuffer[id * 9 + 7] = '0' + data_digit[0];
    if (id == 3)
        TxBuffer[id * 9 + 8] = '\n';
    else
        TxBuffer[id * 9 + 8] = ',';
    HAL_UART_Transmit(&huart1, TxBuffer, sizeof(TxBuffer), 0xffff);
}

void PressureSensor::OutputData()
{
    for (int i = 0; i < SENSOR_NUM; ++i)
    {
        OutputData_single(i);
    }
}

void PressureSensor::OutputData_single(int id)
{
    uint8_t TxBuffer[10] = {0};
    bool IsPositive = true;
    int data_temp = (int)(data_pressure[id] * 1000);
    if (data_pressure[id] < 0)
    {
        IsPositive = false;
        data_temp = -data_temp;
    }
    int data_digit[7];
    for (int j = 0; j < 7; ++j)
    {
        data_digit[j] = data_temp % 10;
        data_temp /= 10;
    }
    if (IsPositive)
        TxBuffer[0] = ' ';
    else
        TxBuffer[0] = '-';
    TxBuffer[1] = '0' + data_digit[6];
    TxBuffer[2] = '0' + data_digit[5];
    TxBuffer[3] = '0' + data_digit[4];
    TxBuffer[4] = '0' + data_digit[3];
    TxBuffer[5] = '.';
    TxBuffer[6] = '0' + data_digit[2];
    TxBuffer[7] = '0' + data_digit[1];
    TxBuffer[8] = '0' + data_digit[0];
    if (id == 3)
        TxBuffer[9] = '\n';
    else
        TxBuffer[9] = ',';
    HAL_UART_Transmit(&huart1, TxBuffer, sizeof(TxBuffer), 0x00ff);
}

void PressureSensor::Handle_single(int id)
{

    data_pressure_raw[id] = MS5837_30BA_GetData(id);
    float temp = data_pressure_raw[id] - data_pressure_offset[id];
    temp = Pressure_Kf[id].update(temp); // First-order low-pass filtering. // 一阶低通滤波
    data_pressure[id] = temp;

    // if (temp < 500 && temp > -10)
    // {
    //     data_pressure[id] = temp;
    // }
    // if(data_pressure[id]>200||data_pressure[id]<-10) data_pressure[id]=last_measure[id]- data_pressure_offset[id];
}

// Following the approach of `Handle_single`, overall efficiency is improved by overlapping the wait time after the first I2C request.
// 仿照Handle_single的思路，通过重叠I2C第一次请求后的等待时间实现整体效率提高
void PressureSensor::Handle_all()
{
    static uint8_t data = MS5837_30BA_ADC_RD;
    static uint8_t command_tmp = MS5837_30BA_D2_OSR1024;
    static uint8_t command_pres = MS5837_30BA_D1_OSR1024;
    static uint8_t temp[3];
    static float tmp_pres;
    static unsigned long conversion[8];    // The upper four bits of `conversion` store temperature data, and the lower four bits store pressure information. //conversion的前四位存储温度数据，后四位存储水压信息

    static uint8_t conv_ok[2 * SENSOR_NUM] = {0};   /* did each transfer succeed? */

    switch (ps_state) {
        case PS_HANDLE_STATE::GET_TEMPERATURE:
            // Notify the sensor to prepare temperature data.
						// 告知传感器准备温度数据
            for (int i = 0; i < SENSOR_NUM; ++i)
            {
                TCA_SetChannel(i);
                conv_ok[i] = (ps_tx(B02_IIC_ADDRESS, &command_tmp, 1) == HAL_OK);
            }
            ps_state = PS_HANDLE_STATE::GET_PRESSURE;
            break;

        case PS_HANDLE_STATE::GET_PRESSURE:
            // Acquire temperature information.
						// 收集温度信息
            for (int i = 0; i < SENSOR_NUM; ++i)
            {
                TCA_SetChannel(i);
                if (ps_tx(B02_IIC_ADDRESS, &data, 1) == HAL_OK &&
                    ps_rx(B02_IIC_ADDRESS, temp, 3) == HAL_OK)
                {
                    conversion[i] = (unsigned long)temp[0] * 65536 +
                                    (unsigned long)temp[1] * 256 + (unsigned long)temp[2];
                }
                else
                {
                    conv_ok[i] = 0;      /* keep the old value, but flag it */
                }
            }

						// Notify the sensor to prepare pressure data.
            // 告知传感器准备压强数据
            for (int i = 0; i < SENSOR_NUM; ++i)
            {
                TCA_SetChannel(i);
                if (ps_tx(B02_IIC_ADDRESS, &command_pres, 1) != HAL_OK)
                {
                    conv_ok[i + 4] = 0;
                }
            }
            ps_state = PS_HANDLE_STATE::CALCULATE;
            break;

        case PS_HANDLE_STATE::CALCULATE:
            // Retrieve the pressure readings.
						// 获取压强数值
            for (int i = 0; i < SENSOR_NUM; ++i)
            {
                TCA_SetChannel(i);
                if (ps_tx(B02_IIC_ADDRESS, &data, 1) == HAL_OK &&
                    ps_rx(B02_IIC_ADDRESS, temp, 3) == HAL_OK)
                {
                    conversion[i + 4] = (unsigned long)temp[0] * 65536 +
                                        (unsigned long)temp[1] * 256 + (unsigned long)temp[2];
                }
                else
                {
                    conv_ok[i + 4] = 0;
                }
            }

						// Refer to `float PressureSensor::MS5837_30BA_GetData(int id)` to compute the four raw pressure values.
            // 参考float PressureSensor::MS5837_30BA_GetData(int id)计算四个原始压强
            /* zero-initialised: `flag_ok[i]` false used to leave pressure[i]
             * uninitialised, so a missing gauge produced garbage in
             * data_pressure[] / data_depth.  未初始化的 pressure[] 会让缺失的
             * 水压计输出垃圾值，这里清零。 */
            float pressure[4] = {0};
            for (int i = 0; i < SENSOR_NUM; ++i)
            {
                if (flag_ok[i])
                {
                    D2_Temp = conversion[i];
                    D1_Pres = conversion[i+4];
                    dT = D2_Temp - (((uint32_t)Cal_C[i][5]) * 256l);
                    SENS = (int64_t)Cal_C[i][1] * 65536l + ((int64_t)Cal_C[i][3] * dT) / 128l;
                    OFF_ = (int64_t)Cal_C[i][2] * 131072l + ((int64_t)Cal_C[i][4] * dT) / 64l;

                    TEMP = 2000l + (int64_t)(dT)*Cal_C[i][6] / 8388608LL;
                    if (TEMP < 2000) // low temp
                    {

                        Ti = (11 * (int64_t)(dT) * (int64_t)(dT) / (34359738368LL));
                        OFFi = (31 * (TEMP - 2000) * (TEMP - 2000)) / 8;
                        SENSi = (63 * (TEMP - 2000) * (TEMP - 2000)) / 32;
                    }
                    else
                    { // high temp
                        Ti = 2 * (dT * dT) / (137438953472LL);
                        OFFi = (1 * (TEMP - 2000) * (TEMP - 2000)) / 16;
                        SENSi = 0;
                    }
                    OFF2 = OFF_ - OFFi;
                    SENS2 = SENS - SENSi;
                    pressure[i] = ((D1_Pres * SENS2) / 2097152.0 - OFF2) / 32768.0 / 100.0;
                }
                // else
                //     return -1;
            }

				// Assign the raw pressures to `data_pressure_raw`, then compute and assign the processed values to `data_pressure`.
        // 把原始压强赋值给data_pressure_raw，计算后给data_pressure赋值
        for (int i = 0; i < SENSOR_NUM; ++i)
        {
            if (!conv_ok[i] || !conv_ok[i + 4])
            {
                /* A transfer failed - do NOT recompute from stale bytes, just keep
                 * the previous filtered value.  传输失败时不要用旧字节重算。 */
                conv_ok[i] = conv_ok[i + 4] = 1;   /* re-arm for the next round */
                continue;
            }
            data_pressure_raw[i] = pressure[i];
            tmp_pres = data_pressure_raw[i] - data_pressure_offset[i];
            tmp_pres = Pressure_Kf[i].update(tmp_pres); // First-order low-pass filtering. // 一阶低通滤波
            data_pressure[i] = tmp_pres;
        }
        ps_state = PS_HANDLE_STATE::GET_TEMPERATURE;
        break;
    }
}

void PressureSensor::Solve_plane_3(float *data, float *h, float *x, float *y, float *z)
{
    float pos_data[9];
    for (int i = 0; i < 3; ++i)
    {
        pos_data[i * 3] = x[i];
        pos_data[i * 3 + 1] = y[i];
        pos_data[i * 3 + 2] = z[i];
    }

    double a = 0, b = 0, c = 0, d = 0;
    Matrix pos(3, 3, pos_data);

    Matrix pos_inv;
    if (pos_inv.inv(pos))
    {

        float a1 = 0, a2 = 0, b1 = 0, b2 = 0, c1 = 0, c2 = 0, ax = 0, bx = 0, cx = 0;

        for (int i = 1; i < 4; ++i)
        {
            a1 -= pos_inv.mat[1][i];
            b1 -= pos_inv.mat[2][i];
            c1 -= pos_inv.mat[3][i];
            a2 -= pos_inv.mat[1][i] * h[i - 1];
            b2 -= pos_inv.mat[2][i] * h[i - 1];
            c2 -= pos_inv.mat[3][i] * h[i - 1];
        }

        ax = a1 * a1 + b1 * b1 + c1 * c1;
        bx = 2 * (a1 * a2 + b1 * b2 + c1 * c2);
        cx = a2 * a2 + b2 * b2 + c2 * c2 - 1;
        data[0] = (-bx - sqrt(bx * bx - 4 * ax * cx)) / (2 * ax);
        data[1] = a1 * d + a2;
        data[2] = b1 * d + b2;
        data[3] = c1 * d + c2;
    }
}

void PressureSensor::Solve_plane(float *data, float *h, float *x, float *y, float *z, int num)
{
    float xi = 0, yi = 0, zi = 0, hi = 0, xi2 = 0, yi2 = 0, zi2 = 0, xiyi = 0, xizi = 0, yizi = 0, xihi = 0, yihi = 0, zihi = 0;
    for (int i = 0; i < num; ++i)
    {
        xi += x[i];
        yi += y[i];
        zi += z[i];
        hi += h[i];
        xi2 += x[i] * x[i];
        yi2 += y[i] * y[i];
        zi2 += z[i] * z[i];
        xiyi += x[i] * y[i];
        xizi += x[i] * z[i];
        yizi += y[i] * z[i];
        xihi += x[i] * h[i];
        yihi += y[i] * h[i];
        zihi += z[i] * h[i];
    }
    float gradient[5] = {0};
    gradient[0] = xi2 * data[0] + xiyi * data[1] + xizi * data[2] + xi * data[3] + xihi + data[0] * data[4];
    gradient[1] = xiyi * data[0] + yi2 * data[1] + yizi * data[2] + yi * data[3] + yihi + data[1] * data[4];
    gradient[2] = xizi * data[0] + yizi * data[1] + zi2 * data[2] + zi * data[3] + zihi + data[2] * data[4];
    gradient[3] = xi * data[0] + yi * data[1] + zi * data[2] + num * data[3] + hi;
    gradient[4] = data[0] * data[0] + data[1] * data[1] + data[2] * data[2] - 1;

    float jacobi_data[25] = {xi2 + data[4], xiyi, xizi, xi, data[0],
                             xiyi, yi2 + data[4], yizi, yi, data[1],
                             xizi, yizi, zi2 + data[4], zi, data[2],
                             xi, yi, zi, (float)num, 0,
                             data[0], data[1], data[2], 0, 0};
    Matrix jacobi(5, 5, jacobi_data);
    Matrix jacobi_inv;
    if (jacobi_inv.inv(jacobi))
    {
        float data_dx[5] = {0};
        for (int i = 0; i < 5; ++i)
        {
            for (int j = 0; j < 5; ++j)
            {
                data_dx[i] += jacobi_inv.mat[i + 1][j + 1] * gradient[j];
            }
            data[i] -= 0.5 * data_dx[i];
        }
    }
}

void PressureSensor::Update_plane()
{
    Solve_plane(data_plane, data_pressure, site.x, site.y, site.z, SENSOR_NUM);

    for (int i = 0; i < 3; ++i)
    {
        data_level[i] = data_plane[i];
    }
}
/*
void PressureSensor::get_angle(float q[4], float *yaw, float *pitch, float *roll)
{
    *yaw = atan2f(2.0f*(q[0]*q[3]+q[1]*q[2]), 2.0f*(q[0]*q[0]+q[1]*q[1])-1.0f);
    *pitch = asinf(-2.0f*(q[1]*q[3]-q[0]*q[2]));
    *roll = atan2f(2.0f*(q[0]*q[1]+q[2]*q[3]),2.0f*(q[0]*q[0]+q[3]*q[3])-1.0f);
}
*/

void Sonar::Init()
{
    data_offset = 0;
    for (int i = 0; i < 100; ++i)
    {
        Handle();
        HAL_Delay(20);
        if (RxBuffer[0] == 0xFF)
            data_offset += (RxBuffer[1] * 256 + RxBuffer[2]) / 100;
    }
}

void Sonar::Handle()
{
    // if(tim_id == 1){
    uint8_t rqst[1] = {' '};
    HAL_UART_Transmit_IT(&huart1, rqst, 1);
    //}
}

void Sonar::Receive()
{
    if (RxBuffer[0] == 0xFF)
    {
        data = RxBuffer[1] * 256 + RxBuffer[2] - data_offset;
    }
    else
        data = -1;

    // HAL_UARTEx_ReceiveToIdle_IT(&huart1, RxBuffer, SERIAL_LENGTH_MAX);
}
