StSandwich/ROV/Code/LL_Modified/userCode/devices/Src/Servo.cpp

//
// Created by admin on 2023/12/5.
//
#include "Servo.h"

int32_t ID_V30[4] = {8, 9, 10, 11}; // Channel indices on the PWM expansion board for the four servos: upper-left, lower-left, upper-right, lower-right. // 4个舵机接在PWM扩展板的编号，左上-左下-右上-右下
int32_t ID_V31[4] = {8, 9, 10, 11};
int32_t ID_V32[4] = {8, 9, 11, 10};
int32_t ID_V33[4] = {8, 9, 10, 11};
int32_t ID_V40[4] = {8, 9, 10, 11}; // Test needed. //还需测试

void Servo::Init()
{
    for (int i = 0; i < SERVO_NUM; ++i)
    {
        data[i] = 1500;
    }
    __HAL_TIM_SetCompare(&htim8, TIM_CHANNEL_3, data[3]);
    __HAL_TIM_SetCompare(&htim1, TIM_CHANNEL_2, data[0]);
    __HAL_TIM_SetCompare(&htim1, TIM_CHANNEL_3, data[2]);
    __HAL_TIM_SetCompare(&htim1, TIM_CHANNEL_4, data[1]);
    HAL_UARTEx_ReceiveToIdle_IT(&huart1, RxBuffer, SERIAL_LENGTH_MAX);
}

void Servo_I2C::Init()
{
    switch (Robot_Version)
    {
    case V30:
        std::memcpy(ID, ID_V30, sizeof(ID));
        break;
    case V31:
        std::memcpy(ID, ID_V31, sizeof(ID));
        break;
    case V32:
        std::memcpy(ID, ID_V32, sizeof(ID));
        break;
    case V33:
        std::memcpy(ID, ID_V33, sizeof(ID));
        break;
    case V40:
        std::memcpy(ID, ID_V40, sizeof(ID));
        break;
    }
    TCA_SetChannel(4);
    PCA_Write(PCA9685_MODE1, 0x0);
    PCA_Setfreq(50); // Hz
    for (int i = 0; i < SERVO_NUM; ++i)
    {
        data[i] = 1500;
				// ------ TODO: `i + 8` denotes the servo channel index on the expansion board. Update this mapping according to the wiring; currently set to channels 8–11.
        //------TODO：i+8为舵机在扩展板上的接口编号，根据接线修改，目前为8-11号
        PCA_Setpwm(i + 8, 0, floor(data[i] * 4096 / 20000 + 0.5f));
    }
    HAL_UARTEx_ReceiveToIdle_IT(&huart1, RxBuffer, SERIAL_LENGTH_MAX);
}

void Servo::Receive()
{
    data_extract(RxBuffer, data, SERVO_NUM);
    // HAL_UARTEx_ReceiveToIdle_IT(&huart1, RxBuffer, SERIAL_LENGTH_MAX);
}

void Servo_I2C::Receive()
{
    data_extract(RxBuffer, data, SERVO_NUM);
    // HAL_UARTEx_ReceiveToIdle_IT(&huart1, RxBuffer, SERIAL_LENGTH_MAX);
}

void Servo::Handle()
{
    __HAL_TIM_SetCompare(&htim8, TIM_CHANNEL_3, data[3]);
    __HAL_TIM_SetCompare(&htim1, TIM_CHANNEL_2, data[0]);
    __HAL_TIM_SetCompare(&htim1, TIM_CHANNEL_3, data[2]);
    __HAL_TIM_SetCompare(&htim1, TIM_CHANNEL_4, data[1]);
}

void Servo_I2C::Handle()
{
    // if(tim_id == 10){
    bool flag_range = true;
    for (int i = 0; i < SERVO_NUM; ++i)
    {
        if (data[i] < 500 || data[i] > 2500)
            flag_range = false;
    }
    if (!flag_range)
    {
        return;
    }

    /* Same optimisation as the thrusters: the servo PWM only has to be sent
     * when the angle changes.  与推进器同理：舵机 PWM 只在角度变化时下发。 */
    static int32_t written[SERVO_NUM] = {-1, -1, -1, -1};
    int32_t duty_count[SERVO_NUM];
    bool changed = false;

    for (int i = 0; i < SERVO_NUM; ++i)
    {
        duty_count[i] = (int32_t)floor(data[i] * 4096 / 20000 + 0.5f);
        if (duty_count[i] != written[i])
        {
            changed = true;
        }
    }
    if (!changed)
    {
        return;
    }

    TCA_SetChannel(4);
    for (int i = 0; i < SERVO_NUM; ++i)
    {
        if (duty_count[i] != written[i])
        {
            PCA_Setpwm(ID[i], 0, duty_count[i]);
            written[i] = duty_count[i];
        }
    }
}

void Servo::data_extract(uint8_t *rx, int32_t *data, int32_t num)
{
    if (strncmp((char *)rx, "MOT:", 4) == 0)
    {

        char *data_str = (char *)rx + 4;
        char *token = strtok(data_str, ",");
        int i = 0;
        while (token != NULL && i < num)
        {
            data[i] = atoi(token);
            token = strtok(NULL, ",");
            i++;
        }
    }
}

void Servo_I2C::data_extract(uint8_t *rx, int32_t *data, int32_t num)
{
    if (strncmp((char *)rx, "MOT:", 4) == 0)
    {
        char *data_str = (char *)rx + 4;
        char *token = strtok(data_str, ",");
        int i = 0;
        while (token != NULL && i < num)
        {
            data[i] = atoi(token);
					  if (i == 2) {data[i] = 3000 - data[i];} 
            token = strtok(NULL, ",");
            i++;
        }
    }
}
