StSandwich/ROV/Code/LL_Modified/userCode/devices/Src/Extension.cpp

//
// Created by admin on 2023/10/29.
//
#include "Extension.h"
// This file is used to handle the I2C expansion board (TCA) and the PWM expansion board (PCA).
// The I2C expansion board is connected to the C-board I2C header (second row from the top, four wires: left—SDA, SCL, VCC, GND—right).
// The PWM expansion board is connected to port 0 of the I2C expansion board.
//此文件用来处理i2c扩展板（TCA）及pwm扩展板（PCA）
//i2c扩展板接在C板i2c口（上方第二排4根线，左-SDA-SCL-VCC-GND-右）
//pwm扩展板接在i2c扩展板的0号口

/* -------------------------------------------------------------------------
 * I2C2 recovery
 * -------------------------------------------------------------------------
 * On this vehicle the I2C bus occasionally glitches (a slave NAKs or holds a
 * line).  The F4 HAL then leaves the handle in HAL_I2C_STATE_BUSY_TX with a
 * sticky ErrorCode, and because every HAL_I2C_* entry point bails out with
 * HAL_BUSY unless the handle is READY, the bus stays dead until the MCU is
 * reset - which silently killed the depth sensor and the PWM expander.
 *
 * Recovery is the standard one: hold SDA released, clock SCL nine times so any
 * slave that is mid-byte finishes and lets go, then emit a STOP and re-init the
 * peripheral.
 * 本车 I2C 偶尔会出问题（从机 NAK 或拉住总线）。F4 的 HAL 会把 handle 卡在
 * BUSY_TX 且 ErrorCode 残留，而 HAL 在 handle 非 READY 时一律直接返回 HAL_BUSY，
 * 于是总线一直死到复位 —— 这就是水深和 PWM 扩展板时好时坏的原因。
 * 恢复办法：SDA 放开，SCL 打 9 个脉冲让从机发完当前字节并松手，发一个 STOP，
 * 再重新初始化外设。
 */
void I2C2_Recover(void)
{
    GPIO_InitTypeDef gpio = {0};

    HAL_I2C_DeInit(&hi2c2);                 /* 释放 PF0/PF1 */

    gpio.Pin   = GPIO_PIN_0 | GPIO_PIN_1;
    gpio.Mode  = GPIO_MODE_OUTPUT_OD;
    gpio.Pull  = GPIO_PULLUP;
    gpio.Speed = GPIO_SPEED_FREQ_VERY_HIGH;
    HAL_GPIO_Init(GPIOF, &gpio);

    HAL_GPIO_WritePin(GPIOF, GPIO_PIN_0, GPIO_PIN_SET);      /* SDA 放开 */
    HAL_GPIO_WritePin(GPIOF, GPIO_PIN_1, GPIO_PIN_SET);
    for (uint32_t i = 0; i < 1000; ++i) __NOP();

    for (uint8_t i = 0; i < 9; ++i)                          /* 9 个时钟 */
    {
        HAL_GPIO_WritePin(GPIOF, GPIO_PIN_1, GPIO_PIN_RESET);
        for (uint32_t d = 0; d < 60; ++d) __NOP();
        HAL_GPIO_WritePin(GPIOF, GPIO_PIN_1, GPIO_PIN_SET);
        for (uint32_t d = 0; d < 60; ++d) __NOP();
    }

    HAL_GPIO_WritePin(GPIOF, GPIO_PIN_0, GPIO_PIN_RESET);    /* STOP */
    for (uint32_t d = 0; d < 60; ++d) __NOP();
    HAL_GPIO_WritePin(GPIOF, GPIO_PIN_1, GPIO_PIN_SET);
    for (uint32_t d = 0; d < 60; ++d) __NOP();
    HAL_GPIO_WritePin(GPIOF, GPIO_PIN_0, GPIO_PIN_SET);
    for (uint32_t d = 0; d < 100; ++d) __NOP();

    MX_I2C2_Init();                          /* 重新配置外设和引脚 */
}

/* Counters so the failure rate can be watched over SWD.
 * 计数器，方便用 SWD 观察出错频率。 */
volatile uint32_t I2C2_ErrorCount   = 0;
volatile uint32_t I2C2_RecoverCount = 0;
/* 分开计数, 用来看是 TCA9548A 还是 PCA9685 在出错 */
volatile uint32_t TCA_ErrorCount = 0;
volatile uint32_t PCA_ErrorCount = 0;

/* Called before an expander access.  HAL_I2C_* clears ErrorCode when it starts a
 * transfer and sets it when the transfer fails, so a non-zero ErrorCode here
 * means the *previous* transfer went wrong - that is the moment to un-wedge the
 * bus.  Rate-limited so a permanently broken bus cannot dominate the loop.
 * 之前那条判据（State != READY && Mode == NONE）会在每次调用都成立，因为 HAL
 * 出错后 State 一直留在 BUSY_TX，结果每笔访问前都做一次恢复，反而把总线搞乱。
 * 现在改成看 ErrorCode（HAL 每次开始传输会清零、失败时置位），并限流。 */
void I2C2_RecoverIfWedged(void)
{
    static uint32_t last = 0;
    uint32_t now = HAL_GetTick();

    if (hi2c2.ErrorCode == HAL_I2C_ERROR_NONE)
    {
        return;
    }
    hi2c2.ErrorCode = HAL_I2C_ERROR_NONE;
    I2C2_ErrorCount++;
    if (now - last < 100U)          /* 最多每 100ms 恢复一次 */
    {
        return;
    }
    last = now;
    I2C2_RecoverCount++;
    I2C2_Recover();
}

// Enable the I2C bus on `channel`.
// 开通第 channel 路的I2C 
void TCA_SetChannel(uint8_t channel)
{
    uint8_t data;
    I2C2_RecoverIfWedged();
    data = 0x01 << channel;
    if (HAL_I2C_Master_Transmit(&hi2c2, (TCA9548A_ADDR << 1) | 0x01, &data, 1,
                                EXPANDER_I2C_TIMEOUT) != HAL_OK)
    {
        TCA_ErrorCount++;
    }
    //HAL_I2C_Master_Transmit(&hi2c2, TCA9548A_ADDR, &data, 1, 0xffff);
}

uint8_t PCA_Read(uint8_t startAddress)
{
		// Set the register address from which data reading starts.
    //设置开始读取数据的寄存器地址
    uint8_t tx[1];
    uint8_t buffer[1];
    tx[0] = startAddress;
    HAL_I2C_Master_Transmit(&hi2c2,PCA9685_ADDR,tx,1,EXPANDER_I2C_TIMEOUT);
    HAL_I2C_Master_Receive(&hi2c2,PCA9685_ADDR,buffer,1,EXPANDER_I2C_TIMEOUT);
    return buffer[0];
}

void PCA_Write(uint8_t startAddress, uint8_t buffer)
{
    I2C2_RecoverIfWedged();
		// Set the register address from which data reading starts.
    //设置开始读取数据的寄存器地址
    uint8_t tx[2];
    tx[0] = startAddress;
    tx[1] = buffer;
    for (uint8_t k = 0; k < 3; ++k)          /* 三写两重试：这条总线上单次失败很常见 */
    {
        if (HAL_I2C_Master_Transmit(&hi2c2, PCA9685_ADDR, tx, 2,
                                    EXPANDER_I2C_TIMEOUT) == HAL_OK)
        {
            return;
        }
    }
    PCA_ErrorCount++;
}

// Set the PWM frequency to `freq`.
// 设置PWM频率为 freq
void PCA_Setfreq(float freq)
{
    uint8_t prescale,oldmode,newmode;
    double prescaleval;
    freq *= 1.016; 			// In practical operation, a bias is observed; multiply by the correction factor 0.83.//实际使用过程中存在偏差需要×矫正系数=0.83
    // prescaleval = 25000000;
    prescaleval = 25000000.0/(4096.0*freq);
    //prescaleval /= freq;
    prescaleval -= 1;
    prescale = floor(prescaleval + 0.5f);		// `floor` is a rounding-down function.	//floor向下取整函数
    oldmode = PCA_Read(PCA9685_MODE1);
    newmode = (oldmode&0x7F) | 0x10; // sleep睡眠
    PCA_Write(PCA9685_MODE1, newmode); // go to sleep; the device must be placed into sleep mode before the frequency can be configured. //需要进入随眠状态才能设置频率
    PCA_Write(PCA9685_PRESCALE, prescale); // Configure the prescaler (pre-divider) value. // 设置预分频系数
    PCA_Write(PCA9685_MODE1, oldmode);
    HAL_Delay(2);
    PCA_Write(PCA9685_MODE1, oldmode | 0xA1);
}

// @brief /Set the PWM value for the specified output channel.
// @param num /PWM output channel index (0–15). Channels 0–7 correspond to thrusters; channels 8–11 correspond to servos.
// @param on  /PWM rising-edge count (0–4096); typically 'on = 0'.
// @param off /PWM falling-edge count (0–4096); the duty cycle is 'off'/4096.

//  @brief 设置对应输出引脚的PWM值
//  @param num PWM输出引脚0 ~ 15, 0 ~ 7 对应推进器， 8 ~ 11 对应舵机
//  @param on PWM上升计数值0 ~ 4096, 一般取 on = 0
//  @param off PWM下降计数值0 ~ 4096, 占空比为 off/4096
void PCA_Setpwm(uint8_t num, uint32_t on, uint32_t off) 
{
    PCA_Write(LED0_ON_L+4*num, on);
    PCA_Write(LED0_ON_H+4*num, on>>8);
    PCA_Write(LED0_OFF_L+4*num, off);
    PCA_Write(LED0_OFF_H+4*num, off>>8);
}



/*void PWM_Extension_init(){
    PCA_Write(PCA9685_MODE1,0x0);
    PCA_Setfreq(50);//Hz
    for(int i=0;i<6;++i){
        PCA_Setpwm(i,0,307);//1500*4096/20000
    }
}

void PWM_Extension(){
    for(int i=0;i<6;++i){
			PCA_Setpwm(i,0,Servo::servo.data[i]*4096/20000);

    }
}

void I2C_Extension_init(){
    TCA_SetChannel(0);
    PWM_Extension_init();
    for(int i=0;i<5;++i){
        TCA_SetChannel(i+1);
        //Init_data_pressure(i);
        PressureSensor::pres_sensor.Init(i);
    }

}

void I2C_Extension(){
    TCA_SetChannel(0);
    PWM_Extension();
    for(int i=0;i<5;++i){
        TCA_SetChannel(i+1);
        //Get_data_pressure(i);
        PressureSensor::pres_sensor.Handle(i);
    }

}
*/



/*函数作用：初始化舵机驱动板参数：1.PWM频率2.初始化舵机角度*/
/*void PCA_MG90_Init(float hz,uint8_t angle)
{
    uint32_t off=0;
    PCA_Write(PCA9685_MODE1,0x0);
    PCA_Setfreq(hz);//设置PWM频率
    off=(uint32_t)(145+angle*2.4);
    PCA_Setpwm(0,0,off);PCA_Setpwm(1,0,off);PCA_Setpwm(2,0,off);PCA_Setpwm(3,0,off);
    PCA_Setpwm(4,0,off);PCA_Setpwm(5,0,off);PCA_Setpwm(6,0,off);PCA_Setpwm(7,0,off);
    PCA_Setpwm(8,0,off);PCA_Setpwm(9,0,off);PCA_Setpwm(10,0,off);PCA_Setpwm(11,0,off);
    PCA_Setpwm(12,0,off);PCA_Setpwm(13,0,off);PCA_Setpwm(14,0,off);PCA_Setpwm(15,0,off);
    HAL_Delay(500);
}*/
/*函数作用：控制舵机转动；参数：1.输出端口，可选0~15； 2.结束角度，可选0~180；*/
/*void PCA_MG90(uint8_t num,uint8_t end_angle)
{
    uint32_t off=0;
    off=(uint32_t)(158+end_angle*2.2);
    PCA_Setpwm(num,0,off);
}*/
