StSandwich/ROV/(commit log)

2026-01-31 feat: update structure model
    [9-16-2.stp.STEP, CNC_Maching.xlsx, CNC加工.xlsx, Cabin.STEP, Cable-passing_Screw.STEP, Configuration.STEP, Front_Cabin_Mount.STEP, Hemispherical_Dome.STEP]
2026-02-08 Update the BOM
    [BOM.xlsx, bom表.xlsx]
2026-10-12 chore: 初始化 fork 维护分支（清理构建产物与历史大文件、统一 GPL-3.0、重写 README）
2026-10-16 移植烧录成功，422通讯从uart6切换到uart1
2026-10-22 阶段性成果，正在验证机械结构
