StSandwich/ROV/(notices)

Notices in the files:
Code/LL_Modified/Src/main.c:
COPYRIGHT(c) 2021 STMicroelectronics
